Marsgate/goosebrain/renders/case/8_clear_side.png

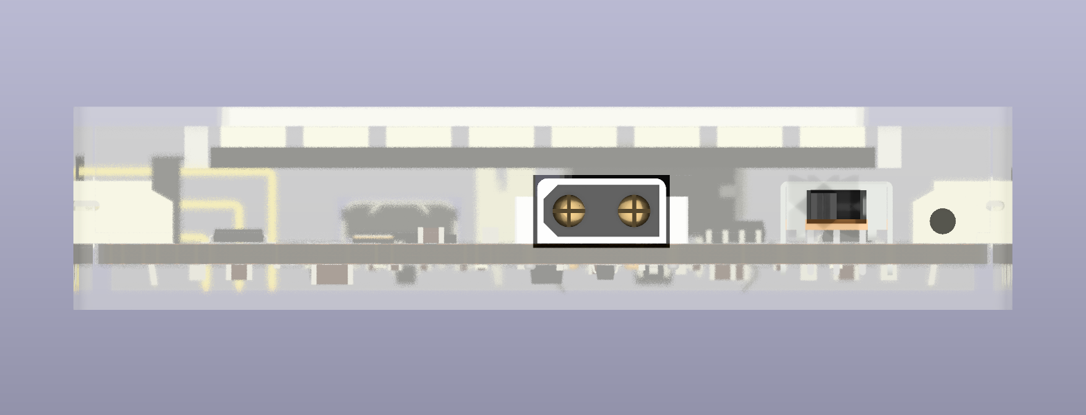
renders/case/8_clear_side.png
