Marsgate/goosebrain/renders/pack/compact_board.png

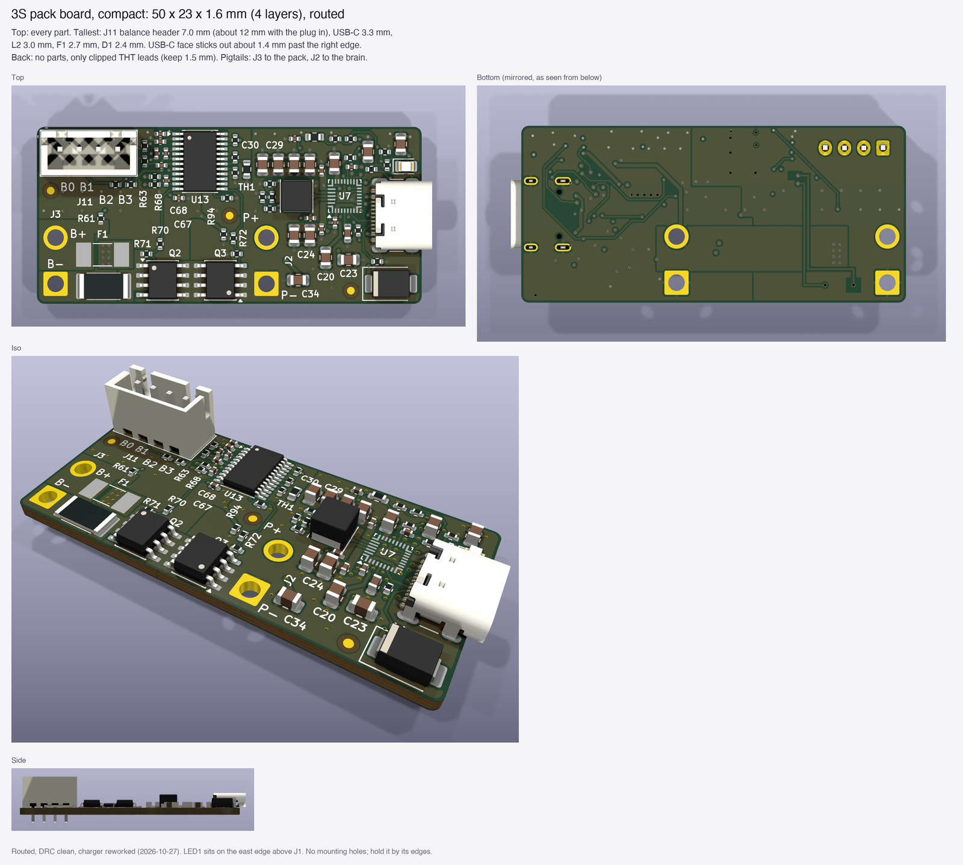
renders/pack/compact_board.png
