Marsgate/goosebrain/docs/ovonic-un38.3-request.md

Subject: UN38.3 test summary and SDS request: Ovonic 80C 11.1V 3S 450mAh XT30

Hello Ovonic team,

I'm designing a small robotics controller that ships with one of your packs installed in the equipment (UN3481), and I'd like to use the Ovonic 80C 11.1V 3S 450mAh LiPo with the XT30 plug:
https://www.ovonicshop.com/products/ovonic-80c-11-1v-3s-450mah-xt30-lipo-battery

Before I commit to it, could you send:

1. The UN38.3 test summary for this exact pack model (3S1P 450mAh 80C), as required for shipments since January 2020.
2. The full UN38.3 test report, if you can share it.
3. The current Safety Data Sheet (SDS/MSDS).
4. The cell model and cell manufacturer used in the pack, and the pack's watt-hour rating.
5. Whether the pack has IEC 62133 certification.

I'm planning an initial order of about [quantity] packs, with more to follow if the documents check out. If buying direct in volume needs a different contact, please point me to them.

Thank you,
[Your name]
[Company or project name]
[Email / phone]
