Marsgate/goosebrain/renders/board/1_top.png

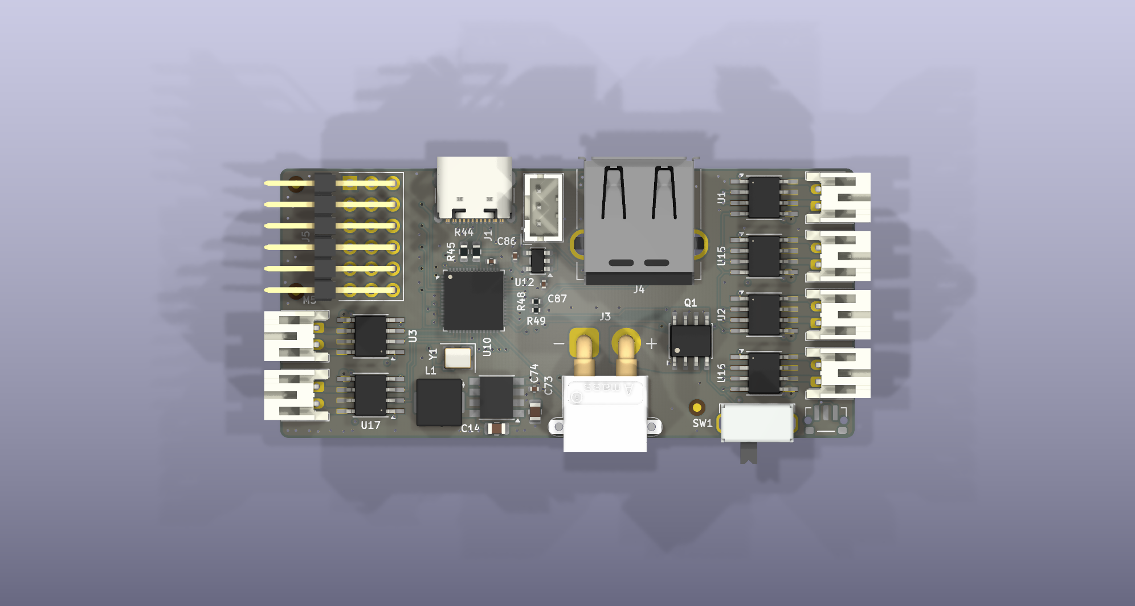
renders/board/1_top.png
