Marsgate/goosebrain/renders/board/2_bottom.png

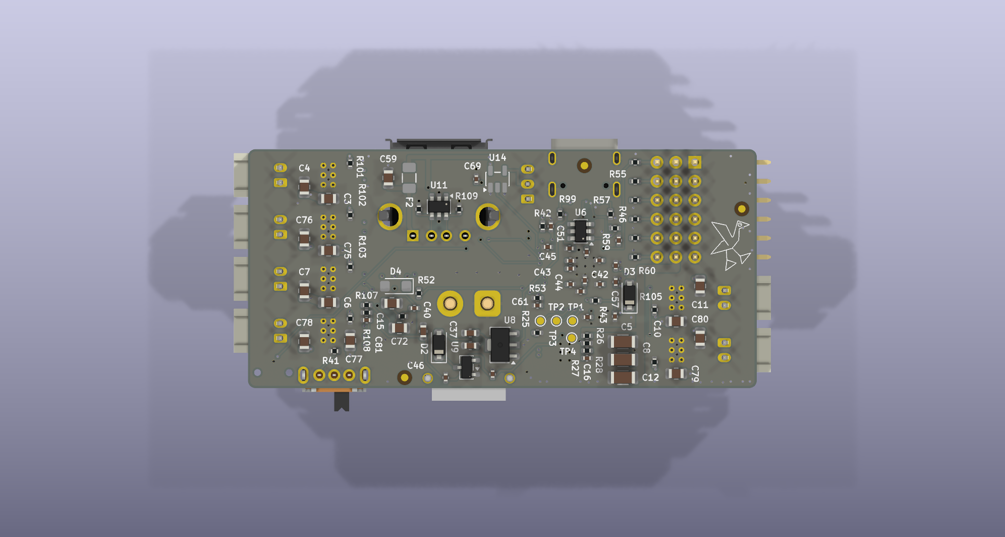
renders/board/2_bottom.png
