Marsgate/goosebrain/renders/board/3_iso_front.png

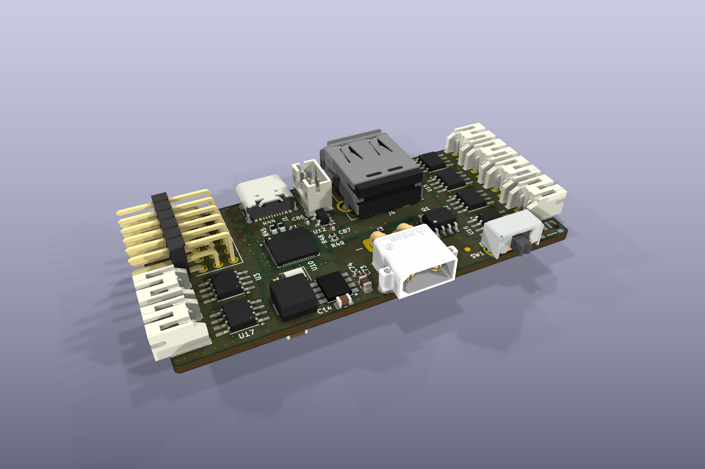
renders/board/3_iso_front.png
