Marsgate/goosebrain/renders/board/4_iso_back_edge.png

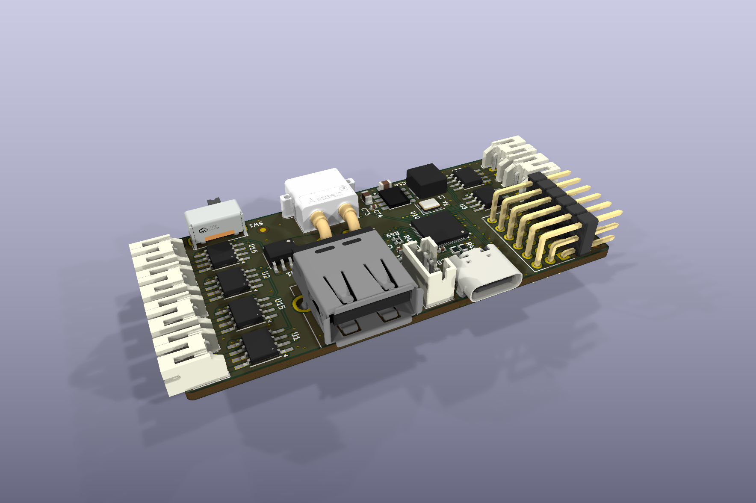
renders/board/4_iso_back_edge.png
