Marsgate/goosebrain/renders/board/5_iso_underside.png

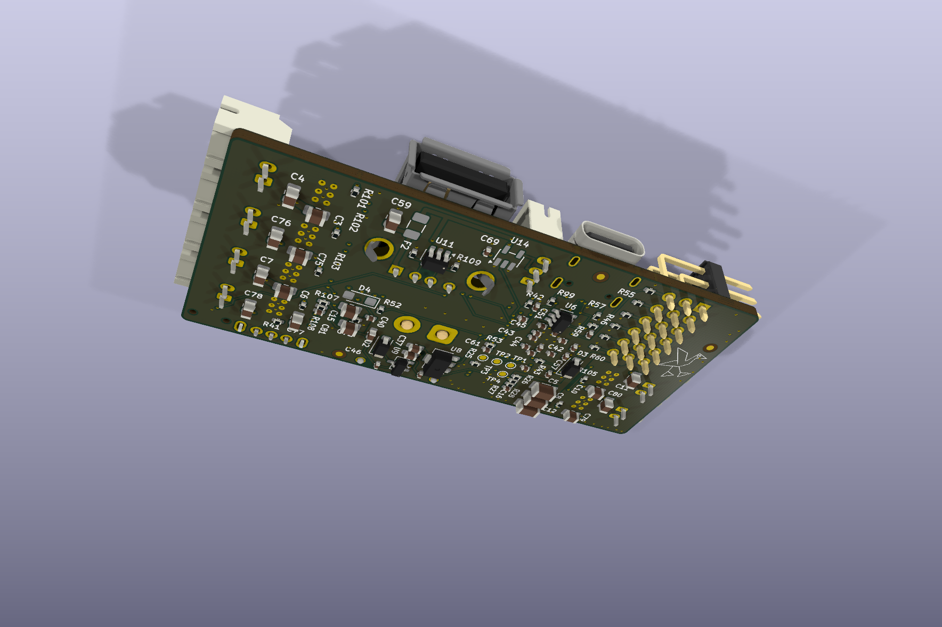
renders/board/5_iso_underside.png
