Marsgate/goosebrain/renders/case/1_on_robot.png

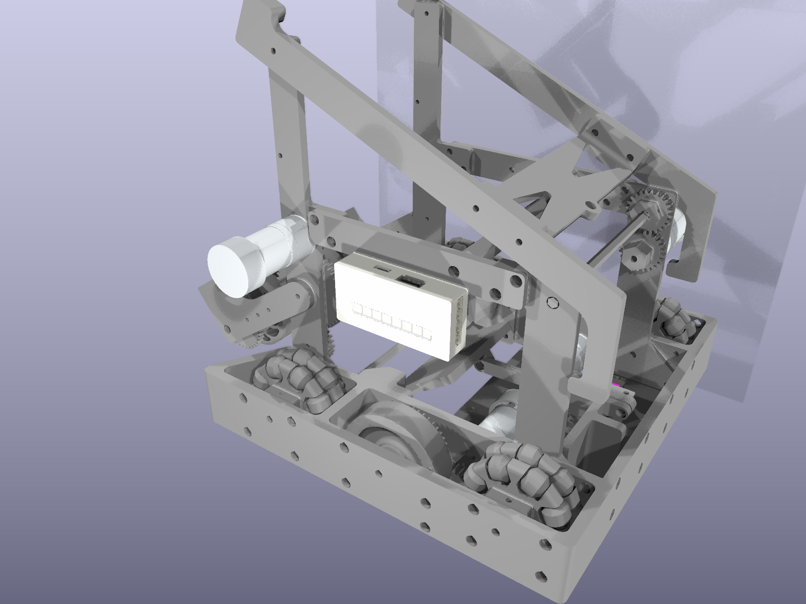
renders/case/1_on_robot.png
