Marsgate/goosebrain/renders/case/2_on_robot_closeup.png

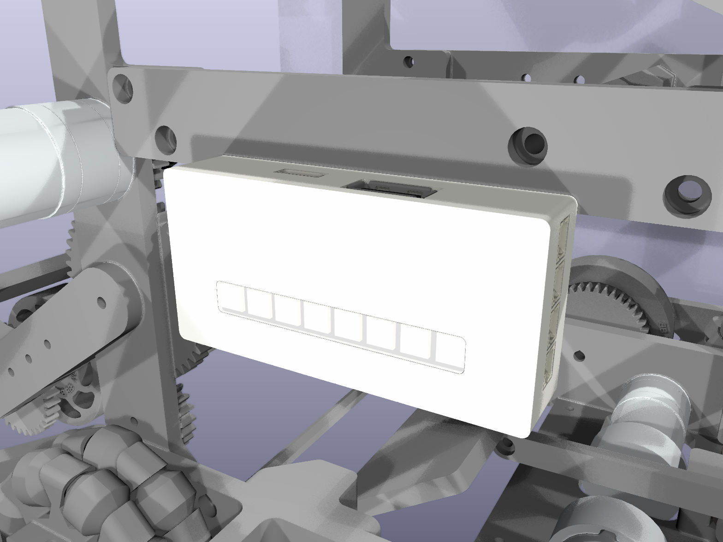
renders/case/2_on_robot_closeup.png
