Marsgate/goosebrain/renders/case/3_case_top_usb.png

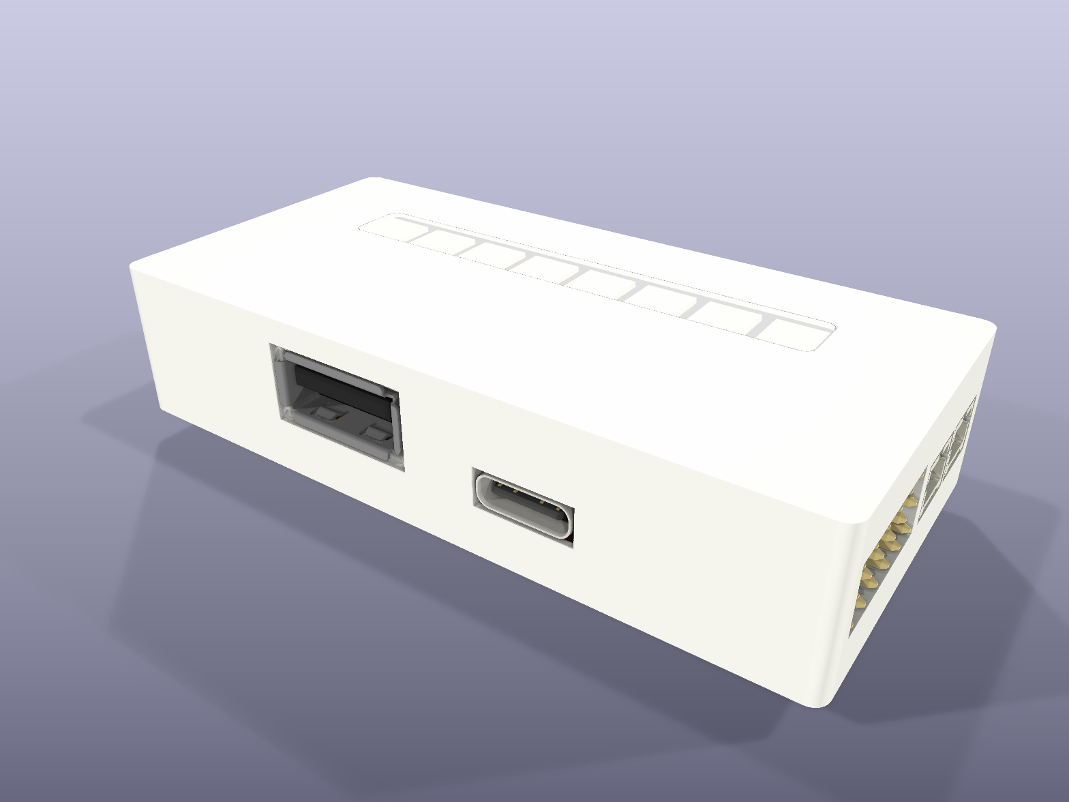
renders/case/3_case_top_usb.png
