Marsgate/goosebrain/renders/case/4_case_left_io.png

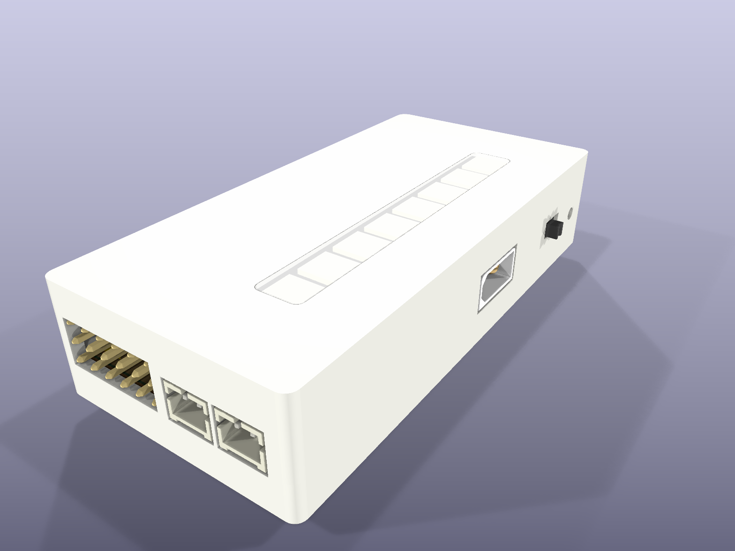
renders/case/4_case_left_io.png
