Marsgate/goosebrain/renders/case/6_case_bottom_power.png

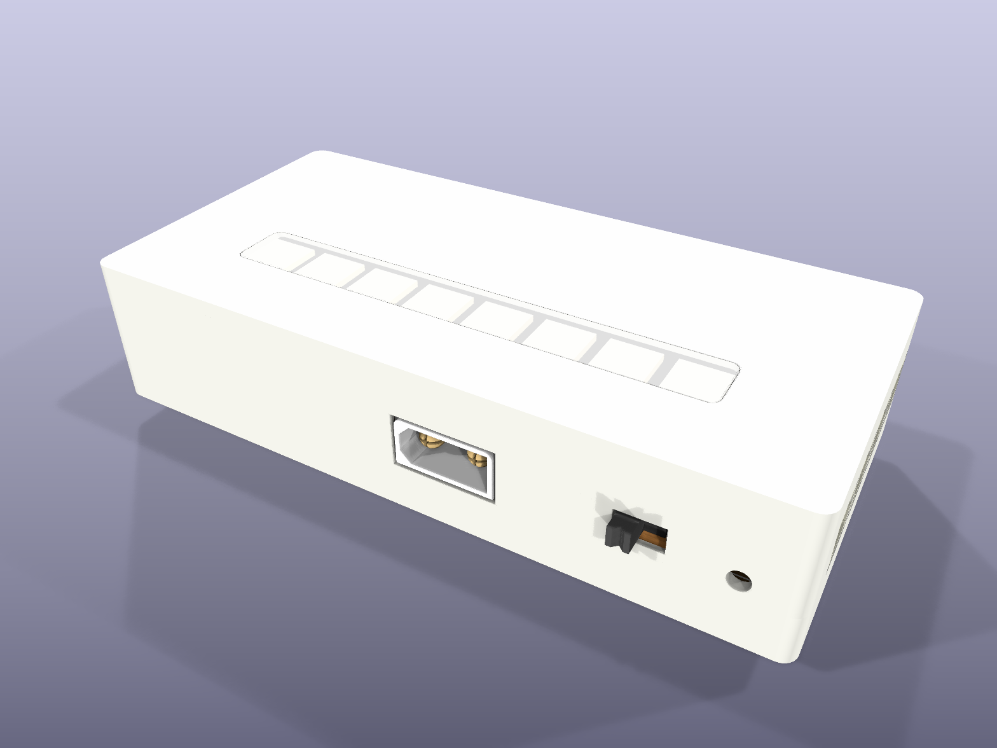
renders/case/6_case_bottom_power.png
