Marsgate/goosebrain/renders/case/7_clear_case.png

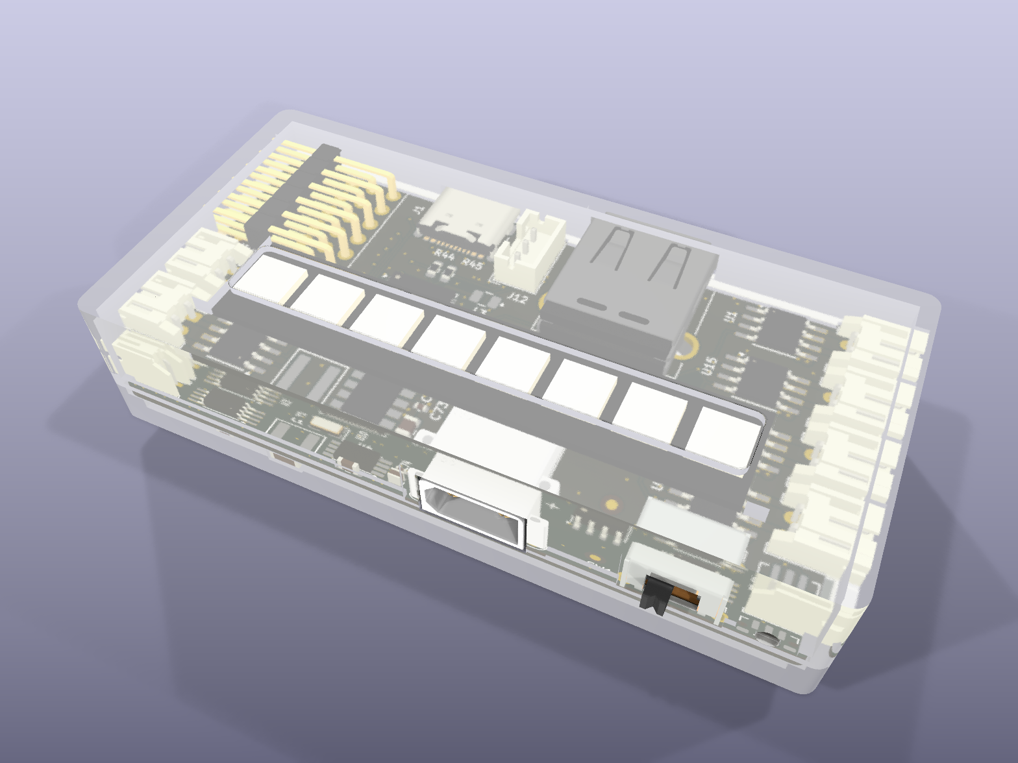
renders/case/7_clear_case.png
