Marsgate/goosebrain/renders/pack/layout_options.png

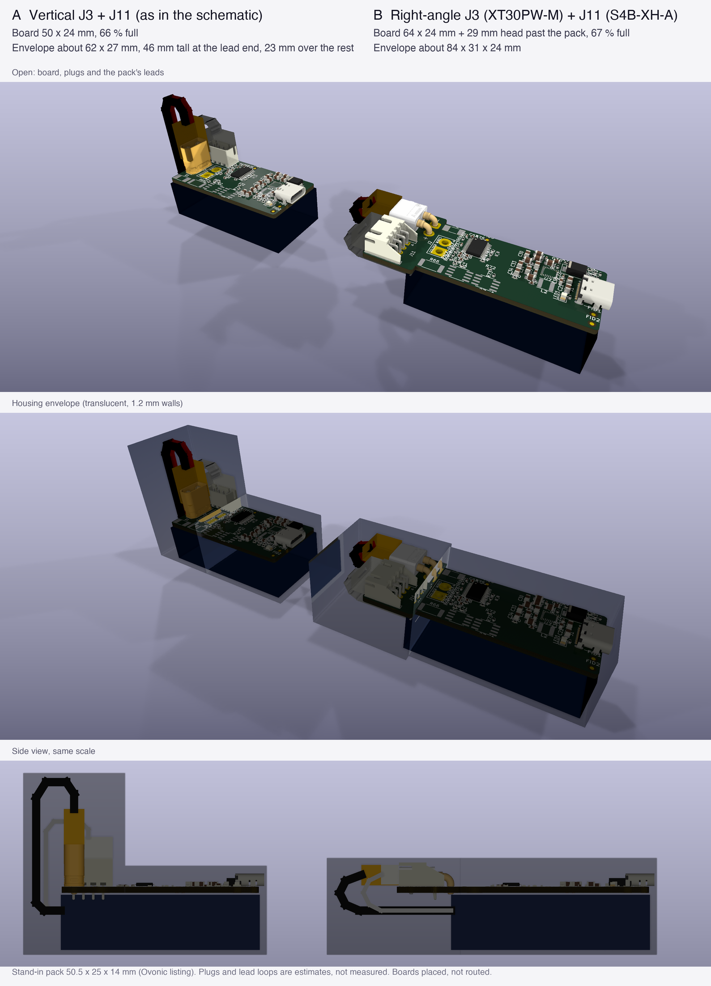
renders/pack/layout_options.png
