Marsgate/goosebrain/renders/pack/pack2s_bottom.png

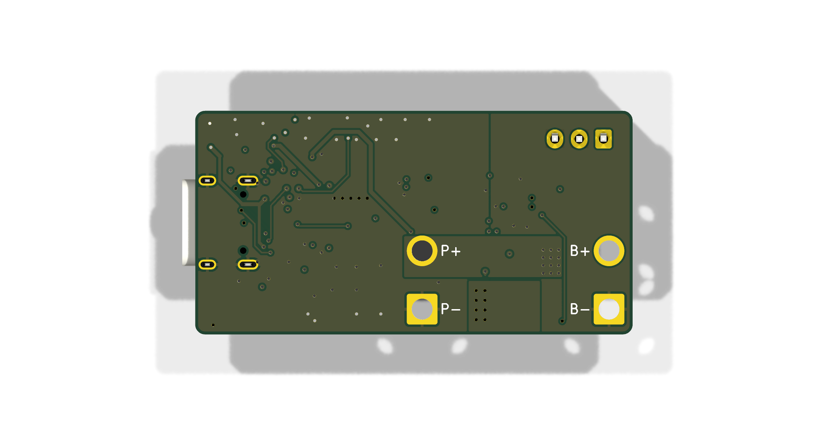
renders/pack/pack2s_bottom.png
