Marsgate/goosebrain/renders/pack/pack2s_iso.png

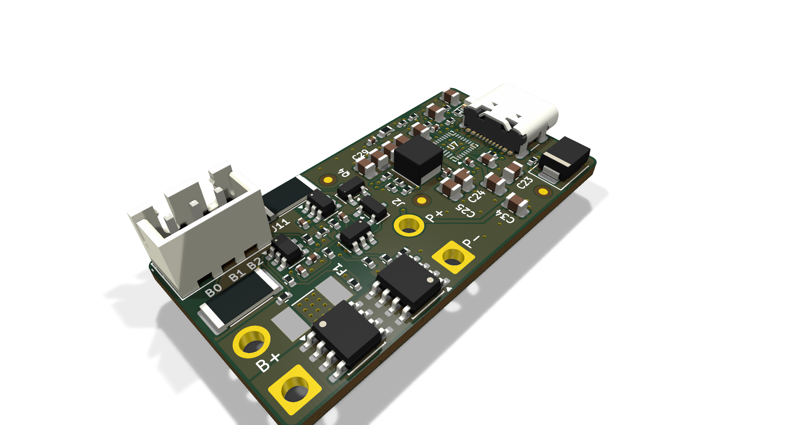
renders/pack/pack2s_iso.png
