Marsgate/goosebrain/renders/pack/pack2s_top.png

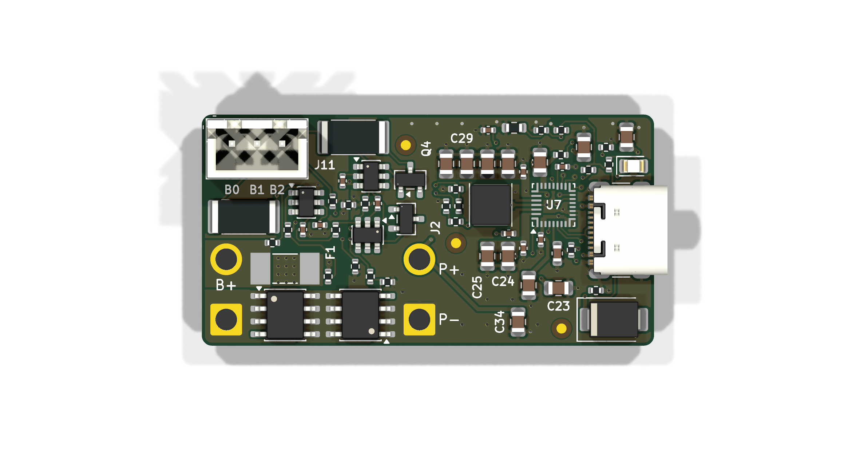
renders/pack/pack2s_top.png
