Marsgate/goosebrain/renders/pack/pack_on_top_vs_brain.png

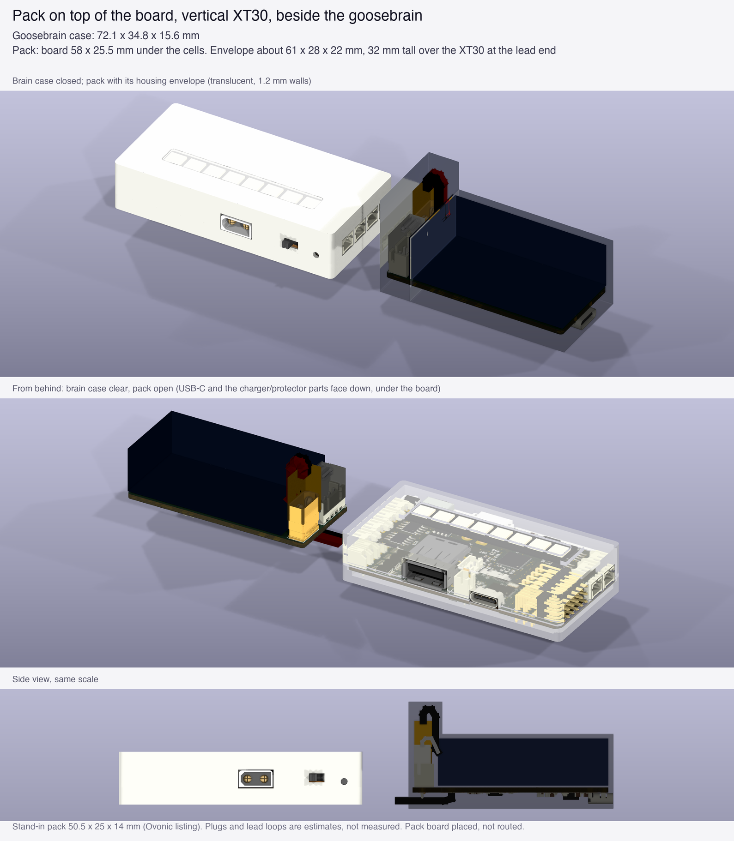
renders/pack/pack_on_top_vs_brain.png
