Marsgate/goosebrain/renders/pack/pack_vs_brain_boards.png

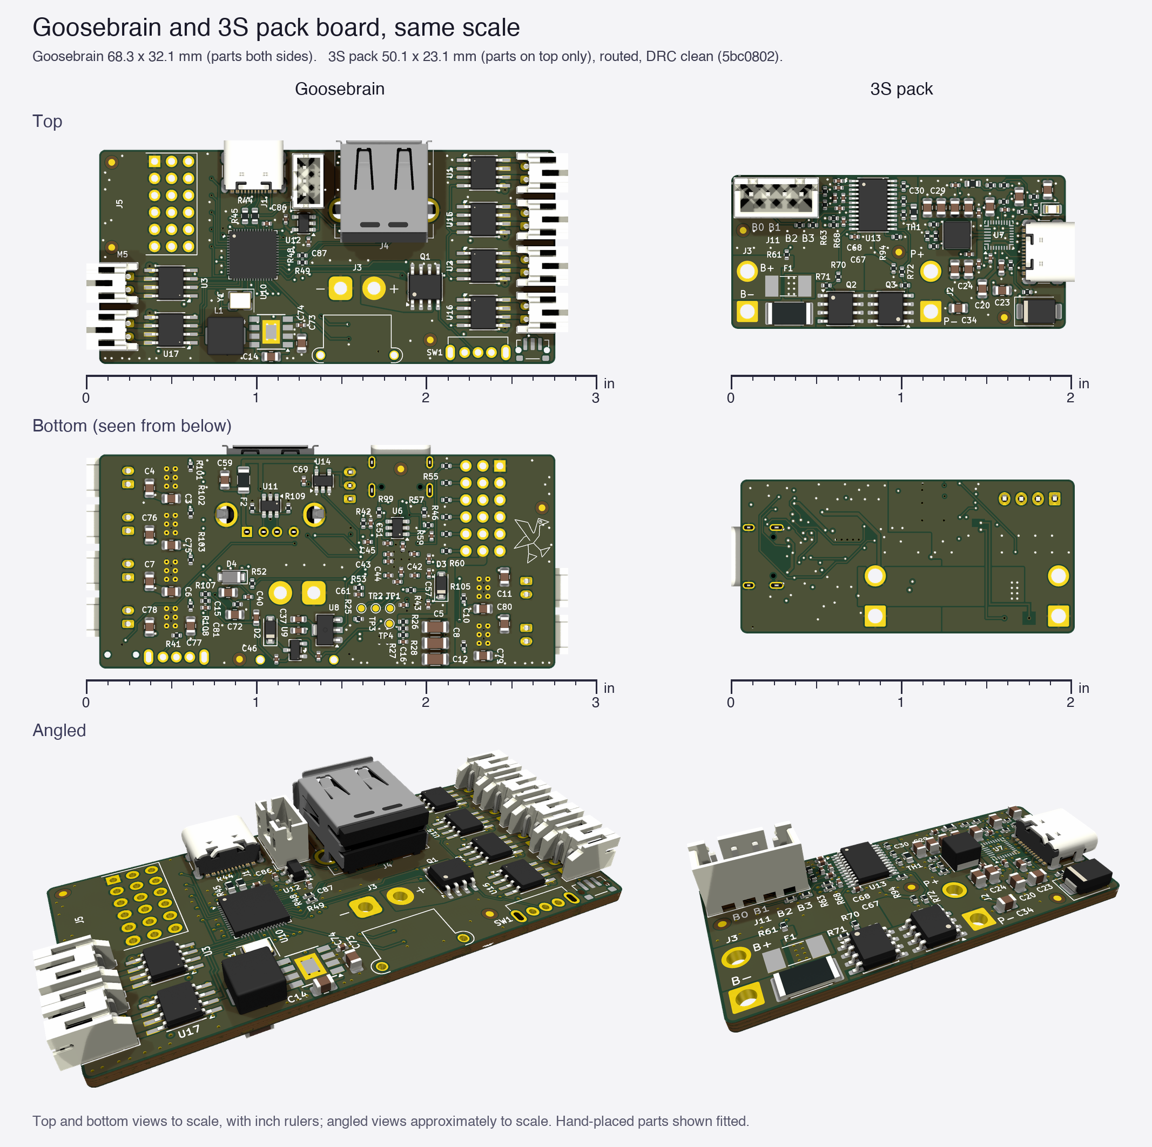
renders/pack/pack_vs_brain_boards.png
