Marsgate/goosebrain/renders/case/case_cover.step

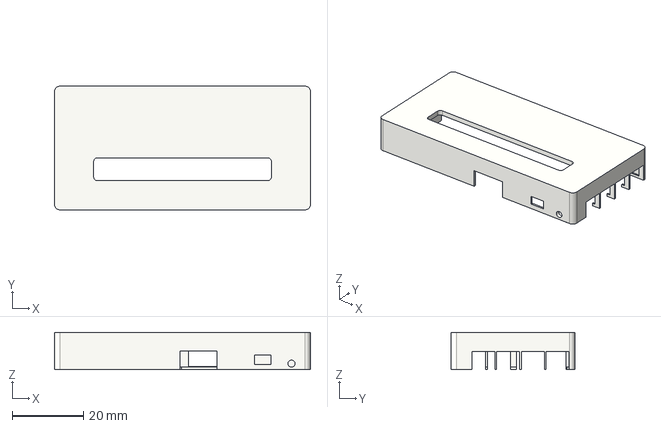
[picture p20: CAD file, 2026-10-20]
renders/case/case_cover.step
72.1 x 34.8 x 10.5 mm
