Marsgate/goosebrain/renders/case/case_diffuser.step

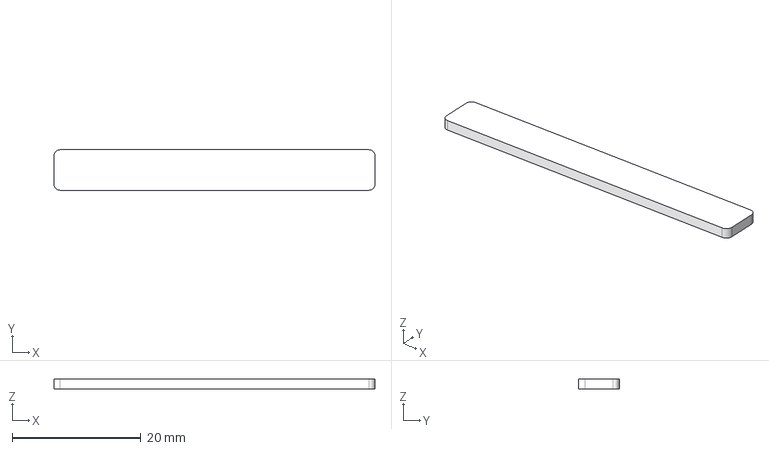
[picture p21: CAD file, 2026-10-20]
renders/case/case_diffuser.step
49.9 x 6.30 x 1.50 mm
