Marsgate/goosebrain/renders/case/led_stick.step

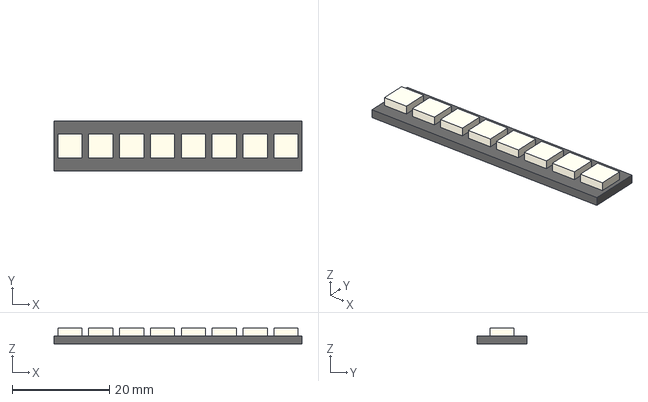
[picture p22: CAD file, 2026-10-20]
renders/case/led_stick.step
51.0 x 10.2 x 3.20 mm
