Marsgate/goosebrain/renders/case/case_tray.step

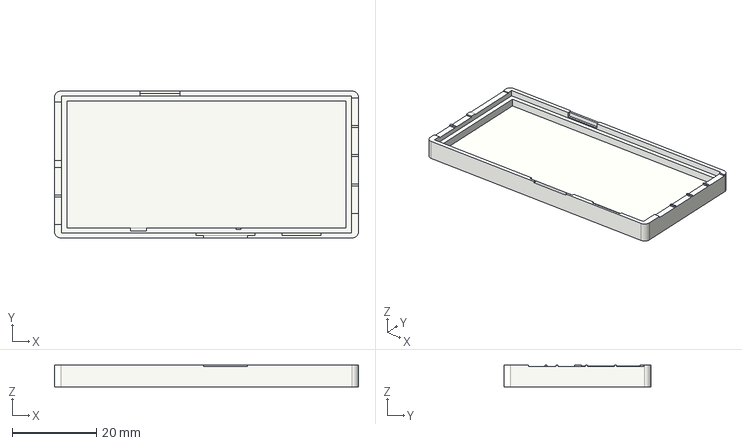
[picture p23: CAD file, 2026-10-20]
renders/case/case_tray.step
72.1 x 34.8 x 5.10 mm
