Marsgate/goosebrain/kicad-pack-2s/goosepack2s.kicad_pcb

## KiCad design kicad-pack-2s/goosepack2s.kicad_pcb (2026-10-29)

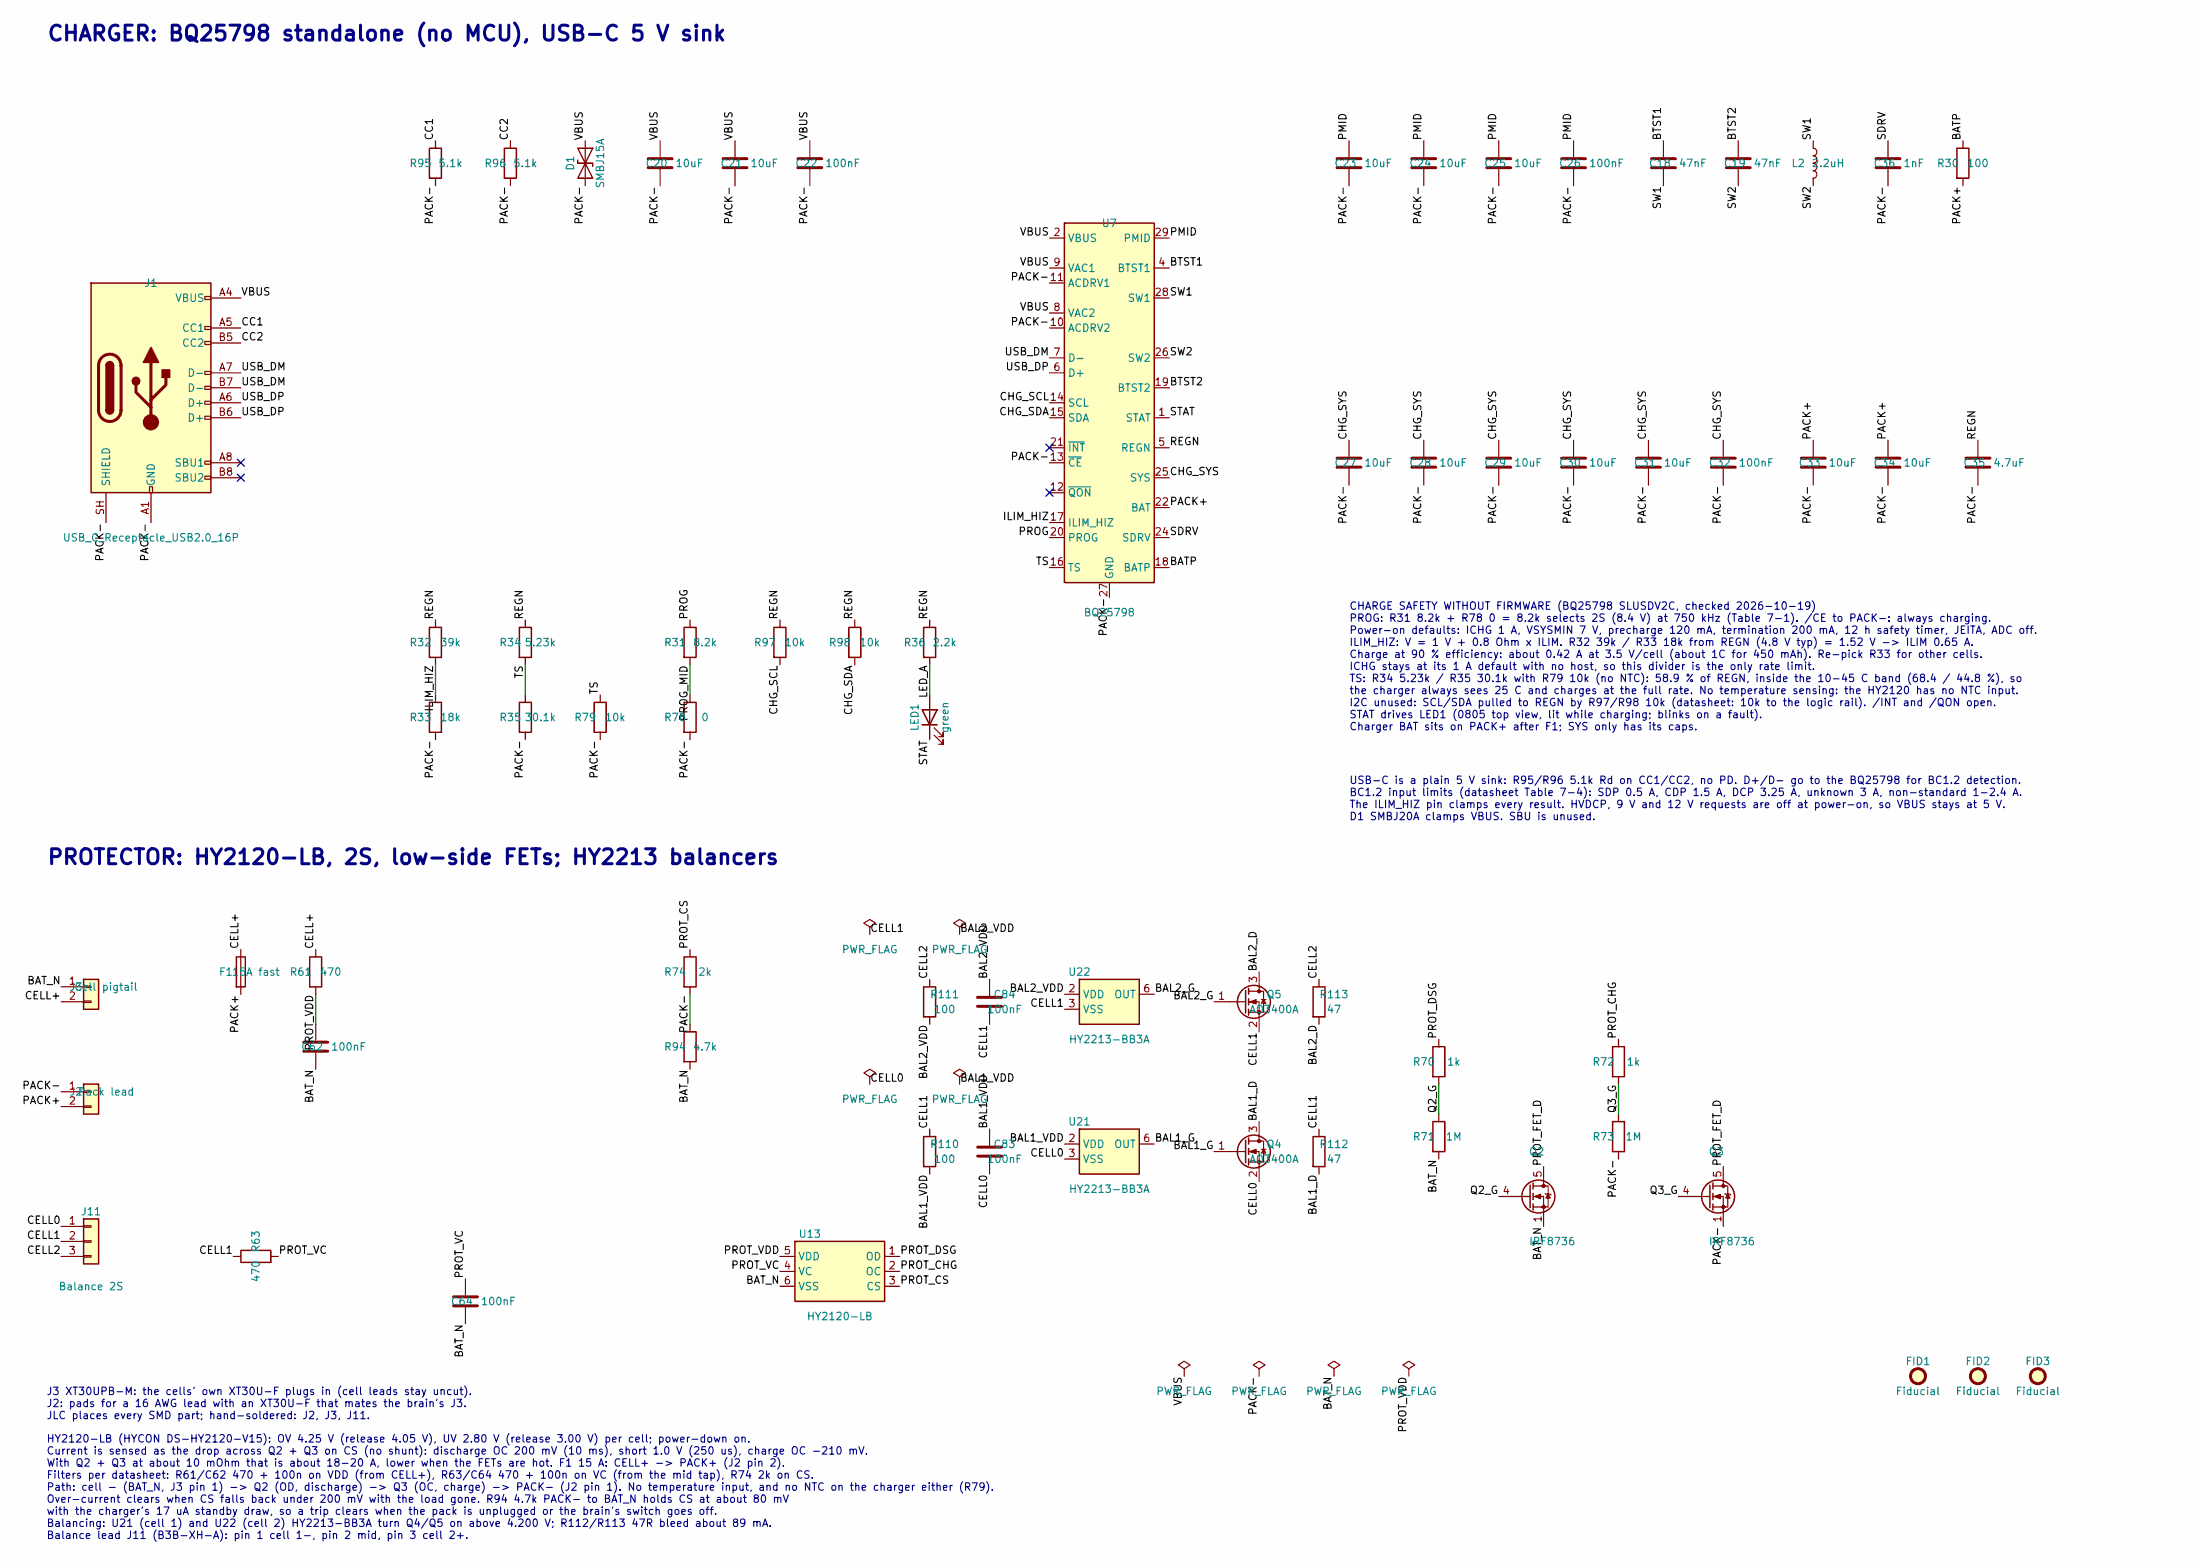
[picture p24: schematic goosepack2s.kicad_sch]

Parts:
C18, C19: 47nF; C_0402_1005Metric; MPN 0402B473K160NT; LCSC Part # C192385
C20, C21, C23, C24, C25, C27, C28, C29, C30, C31, C33, C34: 10uF; C_0805_2012Metric; MPN CL21A106KAYNNNE; LCSC Part # C15850
C22, C26, C32, C62, C64, C83, C84: 100nF; C_0402_1005Metric; MPN CL05B104KO5NNNC; LCSC Part # C1525
C35: 4.7uF; C_0603_1608Metric; MPN CL10A475KO8NNNC; LCSC Part # C19666
C36: 1nF; C_0402_1005Metric; MPN 0402B102K500NT; LCSC Part # C1523
D1: SMBJ15A; D_SMB; MPN SMBJ15A; LCSC Part # C19077569
F1: 15A fast; Fuse_Littelfuse-NANO2-451_453; MPN 0453015.MR; LCSC Part # C178997
FID1, FID2, FID3: Fiducial; Fiducial_1mm_Mask2mm
J1: USB_C_Receptacle_USB2.0_16P; USB_C_Receptacle_ShouHan_TYPE-C16PIN; MPN TYPE-C16PIN; LCSC Part # C393939
J2: Pack lead; SolderWire-1.5sqmm_1x02_P6mm_D1.7mm_OD3mm; MPN XT30U-F; LCSC Part # C99102
J3: Cell pigtail; SolderWire-1.5sqmm_1x02_P6mm_D1.7mm_OD3mm; MPN XT30U-M; LCSC Part # C99101
J11: Balance 2S; JST_XH_B3B-XH-A_1x03_P2.50mm_Vertical; MPN B3B-XH-A(LF)(SN); LCSC Part # C144394
L2: 2.2uH; L_Changjiang_FNR4030S; MPN FNR4030S2R2MT; LCSC Part # C167869
LED1: green; LED_0805_2012Metric; MPN KT-0805G; LCSC Part # C2297
Q2, Q3: IRF8736; SOIC-8_3.9x4.9mm_P1.27mm; MPN IRF8736TRPBF; LCSC Part # C51630
Q4, Q5: AO3400A; SOT-23-3; MPN AO3400A; LCSC Part # C20917
R30, R110, R111: 100; R_0402_1005Metric; MPN 0402WGF1000TCE; LCSC Part # C25076
R31: 8.2k; R_0402_1005Metric; MPN 0402WGF8201TCE; LCSC Part # C25924
R32: 39k; R_0402_1005Metric; MPN 0402WGF3902TCE; LCSC Part # C25783
R33: 18k; R_0402_1005Metric; MPN 0402WGF1802TCE; LCSC Part # C25762
R34: 5.23k; R_0402_1005Metric; MPN RTT025231FTH; LCSC Part # C11631
R35: 30.1k; R_0402_1005Metric; MPN 0402WGF3012TCE; LCSC Part # C29402
R36: 2.2k; R_0402_1005Metric; MPN 0402WGF2201TCE; LCSC Part # C25879
R61, R63: 470; R_0402_1005Metric; MPN 0402WGF4700TCE; LCSC Part # C25117
R70, R72: 1k; R_0402_1005Metric; MPN 0402WGF1001TCE; LCSC Part # C11702
R71, R73: 1M; R_0402_1005Metric; MPN 0402WGF1004TCE; LCSC Part # C26083
R74: 2k; R_0402_1005Metric; MPN 0402WGF2001TCE; LCSC Part # C4109
R78: 0; R_0402_1005Metric; MPN 0402WGF0000TCE; LCSC Part # C17168
R79: 10k; R_0603_1608Metric; MPN 0603WAF1002T5E; LCSC Part # C25804
R94: 4.7k; R_0402_1005Metric; MPN 0402WGF4701TCE; LCSC Part # C25900
R95, R96: 5.1k; R_0402_1005Metric; MPN 0402WGF5101TCE; LCSC Part # C25905
R97, R98: 10k; R_0402_1005Metric; MPN 0402WGF1002TCE; LCSC Part # C25744
R112, R113: 47; R_2512_6332Metric; MPN 25121WJ0470T4E; LCSC Part # C15261
U7: BQ25798; Texas_RQM0029A_VQFN-29_4x4mm_P0.4mm; MPN BQ25798RQMR; LCSC Part # C2876593
U13: HY2120-LB; SOT-23-6; MPN HY2120-LB; LCSC Part # C168778
U21, U22: HY2213-BB3A; SOT-23-6; MPN HY2213-BB3A; LCSC Part # C113632

Connections:
/BAL1_D: Q4.3 (D), R112.2
/BAL1_G: Q4.1 (G), U21.6 (OUT)
/BAL1_VDD: C83.1, R110.2, U21.2 (VDD)
/BAL2_D: Q5.3 (D), R113.2
/BAL2_G: Q5.1 (G), U22.6 (OUT)
/BAL2_VDD: C84.1, R111.2, U22.2 (VDD)
/BATP: R30.1, U7.18 (BATP)
/BAT_N: C62.2, C64.2, J3.1, Q2.1 (S), Q2.2 (S), Q2.3 (S), R71.2, R94.2, U13.6 (VSS)
/BTST1: C18.1, U7.4 (BTST1)
/BTST2: C19.1, U7.19 (BTST2)
/CC1: J1.A5 (CC1), R95.1
/CC2: J1.B5 (CC2), R96.1
/CELL0: C83.2, J11.1, Q4.2 (S), U21.3 (VSS)
/CELL1: C84.2, J11.2, Q5.2 (S), R63.1, R110.1, R112.1, U22.3 (VSS)
/CELL2: J11.3, R111.1, R113.1
/CELL+: F1.1, J3.2, R61.1
/CHG_SCL: R97.2, U7.14 (SCL)
/CHG_SDA: R98.2, U7.15 (SDA)
/CHG_SYS: C27.1, C28.1, C29.1, C30.1, C31.1, C32.1, U7.25 (SYS)
/ILIM_HIZ: R32.2, R33.1, U7.17 (ILIM_HIZ)
/LED_A: LED1.2 (A), R36.2
/PACK+: C33.1, C34.1, F1.2, J2.2, R30.2, U7.22 (BAT), U7.23 (BAT)
/PACK-: C20.2, C21.2, C22.2, C23.2, C24.2, C25.2, C26.2, C27.2, C28.2, C29.2, C30.2, C31.2, C32.2, C33.2, C34.2, C35.2, C36.2, D1.2 (A2), J1.A1 (GND), J1.A12 (GND), J1.B1 (GND), J1.B12 (GND), J1.SH (SHIELD), J2.1, Q3.1 (S), Q3.2 (S), Q3.3 (S), R33.2, R35.2, R73.2, R74.2, R78.2, R79.2, R94.1, R95.2, R96.2, U7.10 (ACDRV2), U7.11 (ACDRV1), U7.13 (~CE), U7.27 (GND)
/PMID: C23.1, C24.1, C25.1, C26.1, U7.29 (PMID)
/PROG: R31.1, U7.20 (PROG)
/PROG_MID: R31.2, R78.1
/PROT_CHG: R72.1, U13.2 (OC)
/PROT_CS: R74.1, U13.3 (CS)
/PROT_DSG: R70.1, U13.1 (OD)
/PROT_FET_D: Q2.5 (D), Q2.6 (D), Q2.7 (D), Q2.8 (D), Q3.5 (D), Q3.6 (D), Q3.7 (D), Q3.8 (D)
/PROT_VC: C64.1, R63.2, U13.4 (VC)
/PROT_VDD: C62.1, R61.2, U13.5 (VDD)
/Q2_G: Q2.4 (G), R70.2, R71.1
/Q3_G: Q3.4 (G), R72.2, R73.1
/REGN: C35.1, R32.1, R34.1, R36.1, R97.1, R98.1, U7.5 (REGN)
/SDRV: C36.1, U7.24 (SDRV)
/STAT: LED1.1 (K), U7.1 (STAT)
/SW1: C18.2, L2.1, U7.28 (SW1)
/SW2: C19.2, L2.2, U7.26 (SW2)
/TS: R34.2, R35.1, R79.1, U7.16 (TS)
/USB_DM: J1.A7 (D-), J1.B7 (D-), U7.7 (D-)
/USB_DP: J1.A6 (D+), J1.B6 (D+), U7.6 (D+)
/VBUS: C20.1, C21.1, C22.1, D1.1 (A1), J1.A4 (VBUS), J1.A9 (VBUS), J1.B4 (VBUS), J1.B9 (VBUS), U7.2 (VBUS), U7.3 (VBUS), U7.8 (VAC2), U7.9 (VAC1)

Notes on the sheet:
CHARGER: BQ25798 standalone (no MCU), USB-C 5 V sink
PROTECTOR: HY2120-LB, 2S, low-side FETs; HY2213 balancers
USB-C is a plain 5 V sink: R95/R96 5.1k Rd on CC1/CC2, no PD. D+/D- go to the BQ25798 for BC1.2 detection. BC1.2 input limits (datasheet Table 7-4): SDP 0.5 A, CDP 1.5 A, DCP 3.25 A, unknown 3 A, non-standard 1-2.4 A. The ILIM_HIZ pin clamps every result. HVDCP, 9 V and 12 V requests are off at pow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
CHARGE SAFETY WITHOUT FIRMWARE (BQ25798 SLUSDV2C, checked 2026-10-19) PROG: R31 8.2k + R78 0 = 8.2k selects 2S (8.4 V) at 750 kHz (Table 7-1). /CE to PACK-: always charging. Power-on defaults: ICHG 1 A, VSYSMIN 7 V, precharge 120 mA, termination 200 mA, 12 h safety timer, JEITA, ADC off. ILIM_HIZ: 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
HY2120-LB (HYCON DS-HY2120-V15): OV 4.25 V (release 4.05 V), UV 2.80 V (release 3.00 V) per cell; power-down on. Current is sensed as the drop across Q2 + Q3 on CS (no shunt): discharge OC 200 mV (10 ms), short 1.0 V (250 us), charge OC -210 mV. With Q2 + Q3 at about 10 mOhm that is about 18-20 A, 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
J3 XT30UPB-M: the cells' own XT30U-F plugs in (cell leads stay uncut). J2: pads for a 16 AWG lead with an XT30U-F that mates the brain's J3. JLC places every SMD part; hand-soldered: J2, J3, J11.

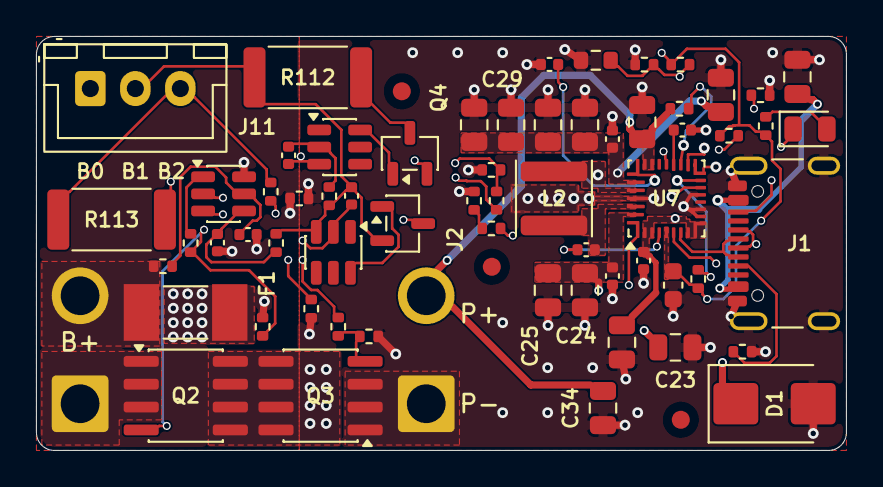
[picture p25: board goosepack2s.kicad_pcb from above]

Board: 4 copper layers, 45.0 x 23.0 mm, 67 parts (0 on the bottom side), 43 nets.
