Marsgate/goosebrain/kicad/thegoose.kicad_pcb

## KiCad design kicad/thegoose.kicad_pcb (2026-10-20)

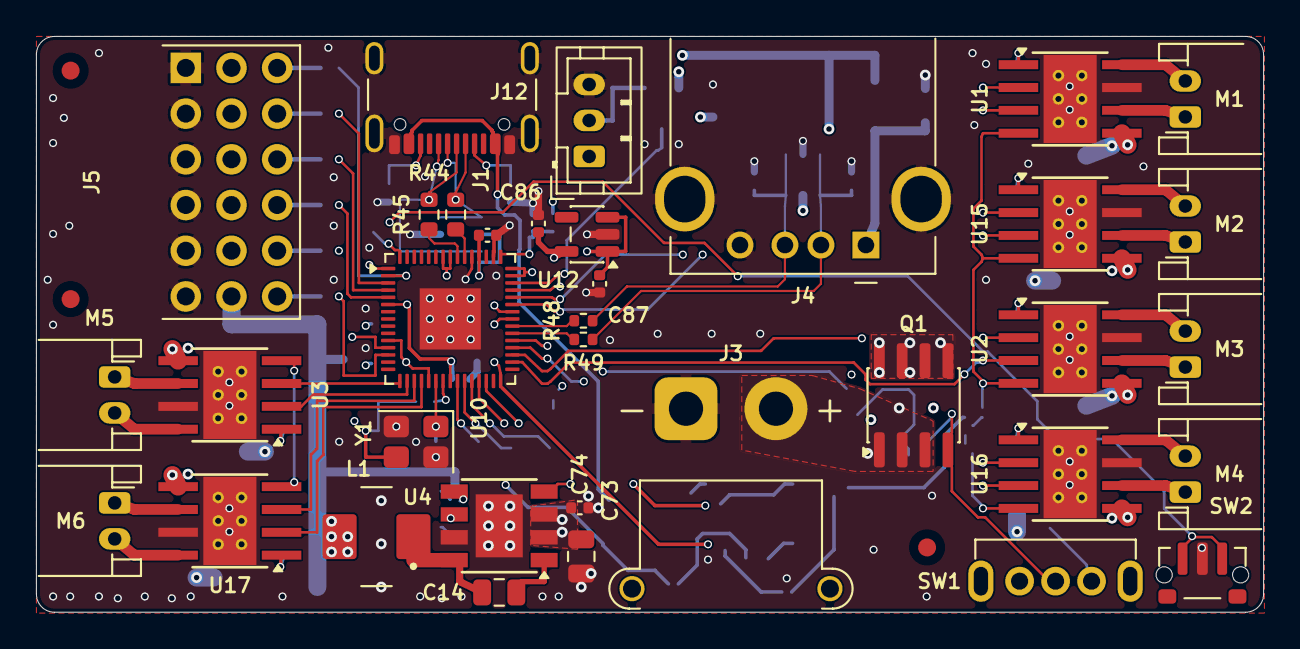
[picture p26: board kicad/thegoose.kicad_pcb from above]

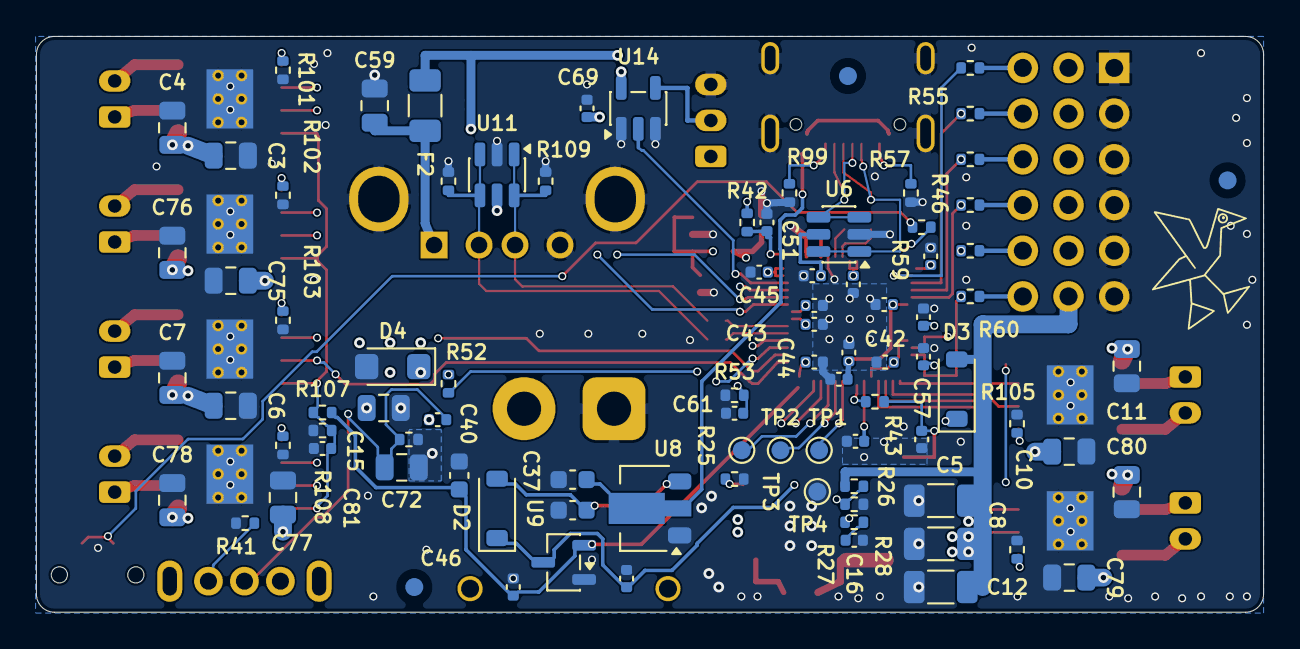
[picture p27: board kicad/thegoose.kicad_pcb from below]

Board: 6 copper layers, 68.2 x 32.0 mm, 127 parts (89 on the bottom side), 83 nets.

Parts:
C3, C6, C10, C15, C59, C73, C75, C77, C79: 10uF; C_0805_2012Metric
C4, C7, C11, C14, C72, C76, C78, C80: 100nF; C_0805_2012Metric
C5, C8, C12: 22uF; C_1206_3216Metric
C16: 4.7nF; C_0402_1005Metric
C37: 1uF; C_0603_1608Metric
C38, C40: 10uF; C_0603_1608Metric
C39: 1uF; C_0402_1005Metric
C41, C42, C43, C44, C45, C46, C47, C48, C49, C53, C54, C55, C61, C69, C74, C81: 100nF; C_0402_1005Metric
C50, C51, C52, C85, C86, C87: 4.7uF; C_0402_1005Metric
C56, C57: 15pF; C_0402_1005Metric
C71: 10nF; C_0402_1005Metric
D2, D3: B5819W; D_SOD-123
D4: SMF14A; D_SMF
F2: 0.5A hold; Fuse_1206_3216Metric
FID1, FID2, FID3, FID4, FID5, FID6: Fiducial; Fiducial_1mm_Mask2mm
J1: USB_C_Receptacle_USB2.0_16P; USB_C_Receptacle_ShouHan_TYPE-C16PIN
J3: XT30PW-M; AMASS_XT30PW-M_1x02_P2.50mm_Horizontal
J4: USB-A host; USB_A_ShouHan_AF90_WJDG
J5: IO 3x6 RA; PinHeader_3x06_P2.54mm_Horizontal_WingTAT
J12: LED stick; JST_PH_B3B-PH-K_1x03_P2.00mm_Vertical
L1: 2.2uH; L_ZengYi_HMS0530
M1, M2, M3, M4, M5, M6: JST_PH_S2B-PH-K_1x02_P2.00mm_Horizontal
Q1: AO4407A; SOIC-8_3.9x4.9mm_P1.27mm
R25: 200k; R_0402_1005Metric
R26: 39k; R_0402_1005Metric
R27: 7.5k; R_0402_1005Metric
R28, R109, R114: 15k; R_0402_1005Metric
R40: 47k; R_0402_1005Metric
R41: 4.7k; R_0402_1005Metric
R42: 33; R_0402_1005Metric
R43, R46: 1k; R_0402_1005Metric
R44, R45: 27; R_0603_1608Metric
R48, R49: 22; R_0402_1005Metric
R52: 100k; R_0402_1005Metric
R53: 27k; R_0402_1005Metric
R55, R56, R57, R58, R59, R60: 330; R_0402_1005Metric
R99, R100: 5.1k; R_0402_1005Metric
R101, R102, R103, R104, R105, R106: 1.2k; R_0402_1005Metric
R107: 10k; R_0402_1005Metric
R108: 33k; R_0402_1005Metric
SW1: Power; SW_SPDT_ShouHan_SK12D07VG4
SW2: BOOT; SW_Push_1P1T-MP_NO_Horizontal_Alps_SKRTLAE010_JLC
TP1: SWCLK; TestPoint_Pad_D1.0mm
TP2: SWDIO; TestPoint_Pad_D1.0mm
TP3: RUN; TestPoint_Pad_D1.0mm
TP4: GND; TestPoint_Pad_D1.0mm
U1, U2, U3, U15, U16, U17: DRV8251A; Texas_HTSOP-8-1EP_3.9x4.9mm_P1.27mm_EP2.95x4.9mm_Mask2.4x3.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
U4: AP64500SP-13; Diodes_SO-8EP
U6, U11: SRV05-4; SOT-23-6
U8: HT7550-1; SOT-89-3
U9: XC6206P332MR; SOT-23-3
U10: RP2354A; QFN-60-1EP_7x7mm_P0.4mm_EP3.4x3.4mm
U12: TLV74311PDBV; SOT-23-5
U14: 74AHCT1G125; SOT-23-5
Y1: 12MHz; Crystal_SMD_3225-4Pin_3.2x2.5mm

Connections:
+1V1: C52.1, C53.1, C54.1, C55.1, C86.1, U10.6 (DVDD), U10.23 (DVDD), U10.39 (DVDD), U12.5
+3V3: C40.1, C41.1, C42.1, C43.1, C44.1, C45.1, C46.1, C47.1, C48.1, C49.1, C50.1, C85.1, C87.1, R42.1, R107.1, U6.5 (VP), U9.2 (VOUT), U10.1 (IOVDD), U10.11 (IOVDD), U10.20 (IOVDD), U10.30 (IOVDD), U10.38 (IOVDD), U10.44 (ADC_AVDD), U10.45 (IOVDD), U10.49 (VREG_VIN), U10.53 (USB_OTP_VDD), U10.54 (QSPI_IOVDD), U12.1, U12.3
/MCU & USB/BAT_SENSE: C61.1, R52.2, R53.1, U10.42 (GPIO28/ADC2)
/MCU & USB/RUN: TP3.1 (1_1), U10.26 (RUN)
/MCU & USB/USBA_GPIO_N: R49.1, U10.36 (GPIO24)
/MCU & USB/USBA_GPIO_P: R48.1, U10.37 (GPIO25)
/MCU & USB/USBA_N: J4.2 (D-), R49.2, R114.1, U11.3 (IO2), U11.4 (IO3)
/MCU & USB/USBA_P: J4.3 (D+), R48.2, R109.1, U11.1 (IO1), U11.6 (IO4)
/MCU & USB/USB_MCU_N: R45.1, U10.51 (USB_DM)
/MCU & USB/USB_MCU_P: R44.1, U10.52 (USB_DP)
/Motor drivers/MOT_VREF: C81.1, R107.2, R108.1, U1.4 (VREF), U2.4 (VREF), U3.4 (VREF), U15.4 (VREF), U16.4 (VREF), U17.4 (VREF)
/Motor drivers/U1_IPROPI: R101.1, U1.1 (IPROPI)
/Motor drivers/U1_OUT1: M1.1, U1.6 (OUT1)
/Motor drivers/U1_OUT2: M1.2, U1.8 (OUT2)
/Motor drivers/U2_IPROPI: R103.1, U2.1 (IPROPI)
/Motor drivers/U2_OUT1: M3.1, U2.6 (OUT1)
/Motor drivers/U2_OUT2: M3.2, U2.8 (OUT2)
/Motor drivers/U3_IPROPI: R105.1, U3.1 (IPROPI)
/Motor drivers/U3_OUT1: M5.1, U3.6 (OUT1)
/Motor drivers/U3_OUT2: M5.2, U3.8 (OUT2)
/Motor drivers/U15_IPROPI: R102.1, U15.1 (IPROPI)
/Motor drivers/U15_OUT1: M2.2, U15.8 (OUT2)
/Motor drivers/U15_OUT2: M2.1, U15.6 (OUT1)
/Motor drivers/U16_IPROPI: R104.1, U16.1 (IPROPI)
/Motor drivers/U16_OUT1: M4.2, U16.8 (OUT2)
/Motor drivers/U16_OUT2: M4.1, U16.6 (OUT1)
/Motor drivers/U17_IPROPI: R106.1, U17.1 (IPROPI)
/Motor drivers/U17_OUT1: M6.2, U17.8 (OUT2)
/Motor drivers/U17_OUT2: M6.1, U17.6 (OUT1)
/Power/CC1: J1.A5 (CC1), R99.1
/Power/CC2: J1.B5 (CC2), R100.1
GND: C3.1, C4.2, C5.2, C6.1, C7.2, C8.2, C10.1, C11.2, C12.2, C15.1, C16.1, C37.2, C38.2, C39.2, C40.2, C41.2, C42.2, C43.2, C44.2, C45.2, C46.2, C47.2, C48.2, C49.2, C50.2, C51.2, C52.2, C53.2, C54.2, C55.2, C56.2, C57.2, C59.2, C61.2, C69.2, C73.1, C74.1, C75.2, C76.2, C77.2, C78.2, C79.2, C80.2, C81.2, C85.2, C86.2, C87.2, D4.2 (A2), J1.A1 (GND), J1.A12 (GND), J1.B1 (GND), J1.B12 (GND), J1.SH (SHIELD), J3.1, J4.4 (GND), J4.SH (Shield), J5.1 (GND), J5.4 (GND), J5.7 (GND), J5.10 (GND), J5.13 (GND), J5.16 (GND), J12.3, R25.1, R27.1, R41.2, R53.2, R99.2, R100.2, R101.2, R102.2, R103.2, R104.2, R105.2, R106.2, R108.2, R109.2, R114.2, SW2.2, TP4.1 (1_1), U1.7 (GND), U1.9 (GND), U2.7 (GND), U2.9 (GND), U3.7 (GND), U3.9 (GND), U4.7 (GND), U4.9 (EP), U6.2 (VN), U8.1 (GND), U9.1 (GND), U10.47 (VREG_PGND), U10.50 (VREG_FB), U10.61 (GND), U11.2 (VN), U12.2, U14.1, U14.3 (GND), U15.7 (GND), U15.9 (GND), U16.7 (GND), U16.9 (GND), U17.7 (GND), U17.9 (GND), Y1.2 (G), Y1.4 (G)
GPIO12_M5A: U3.3 (IN1), U10.16 (GPIO12)
GPIO13_M5B: U3.2 (IN2), U10.17 (GPIO13)
GPIO14_M6A: U10.18 (GPIO14), U17.3 (IN1)
GPIO15_M6B: U10.19 (GPIO15), U17.2 (IN2)
GPIO16_M4A: U10.27 (GPIO16), U16.3 (IN1)
GPIO17_M4B: U10.28 (GPIO17), U16.2 (IN2)
GPIO20_M3A: U2.3 (IN1), U10.32 (GPIO20)
GPIO21_M3B: U2.2 (IN2), U10.33 (GPIO21)
GPIO22_M2A: U10.34 (GPIO22), U15.3 (IN1)
GPIO23_M2B: U10.35 (GPIO23), U15.2 (IN2)
GPIO26_M1A: U1.3 (IN1), U10.40 (GPIO26/ADC0)
GPIO27_M1B: U1.2 (IN2), U10.41 (GPIO27/ADC1)
IO1_GPIO: R55.1, U10.2 (GPIO0)
IO2_GPIO: R56.1, U10.3 (GPIO1)
IO3_GPIO: R57.1, U10.4 (GPIO2)
IO4_GPIO: R58.1, U10.5 (GPIO3)
IO5_GPIO: R59.1, U10.12 (GPIO8)
IO6_GPIO: R60.1, U10.13 (GPIO9)
LED_DIN: U10.43 (GPIO29/ADC3), U14.2
unnamed: C16.2, R28.1
unnamed: C57.1, R43.2, Y1.3
unnamed: C38.1, D2.2 (A), U8.3 (VOUT)
unnamed: C39.1, D2.1 (K), D3.1 (K), U9.3 (VIN)
unnamed: C59.1, F2.2, J4.1 (VBUS)
unnamed: J5.3 (SIG), R55.2
unnamed: J5.6 (SIG), R56.2
unnamed: J5.9 (SIG), R57.2
unnamed: J5.12 (SIG), R58.2
unnamed: J5.15 (SIG), R59.2
unnamed: J5.18 (SIG), R60.2
unnamed: J12.2, U14.4
unnamed: C71.1, C72.2, Q1.4 (G), R40.2, SW1.2 (B)
unnamed: R46.2, SW2.1
unnamed: R41.1, SW1.1 (A)
unnamed: C14.2, U4.1 (BST)
unnamed: R28.2, U4.6 (COMP)
unnamed: R26.1, R27.2, U4.5 (FB)
unnamed: R25.2, U4.4 (RT/CLK)
unnamed: C14.1, L1.1, U4.8 (SW)
unnamed: TP1.1 (1_1), U10.24 (SWCLK)
unnamed: TP2.1 (1_1), U10.25 (SWDIO)
unnamed: C51.1, R42.2, U10.46 (VREG_AVDD)
unnamed: C56.1, U10.21 (XIN), Y1.1
unnamed: R43.1, U10.22 (XOUT)
unnamed: R46.1, U10.60 (~QSPI_SS)
PACK+: C72.1, J3.2, Q1.1 (S), Q1.2 (S), Q1.3 (S), R40.1
USB_N: J1.A7 (D-), J1.B7 (D-), R45.2, U6.3 (IO2), U6.4 (IO3)
USB_P: J1.A6 (D+), J1.B6 (D+), R44.2, U6.1 (IO1), U6.6 (IO4)
VBUS: C37.1, J1.A4 (VBUS), J1.A9 (VBUS), J1.B4 (VBUS), J1.B9 (VBUS), U8.2 (VIN)
VCC: C5.1, C8.1, C12.1, C69.1, D3.2 (A), F2.1, J5.2 (5V), J5.5 (5V), J5.8 (5V), J5.11 (5V), J5.14 (5V), J5.17 (5V), J12.1, L1.2, R26.2, U11.5 (VP), U14.5 (VCC)
VSYS: C3.2, C4.1, C6.2, C7.1, C10.2, C11.1, C15.2, C71.2, C73.2, C74.2, C75.1, C76.1, C77.1, C78.1, C79.1, C80.1, D4.1 (A1), Q1.5 (D), Q1.6 (D), Q1.7 (D), Q1.8 (D), R52.1, U1.5 (VM), U2.5 (VM), U3.5 (VM), U4.2 (VIN), U4.3 (EN), U15.5 (VM), U16.5 (VM), U17.5 (VM)
