Marsgate/goosebrain/thegoose.kicad_pcb

## KiCad design thegoose.kicad_pcb (2026-08-02)

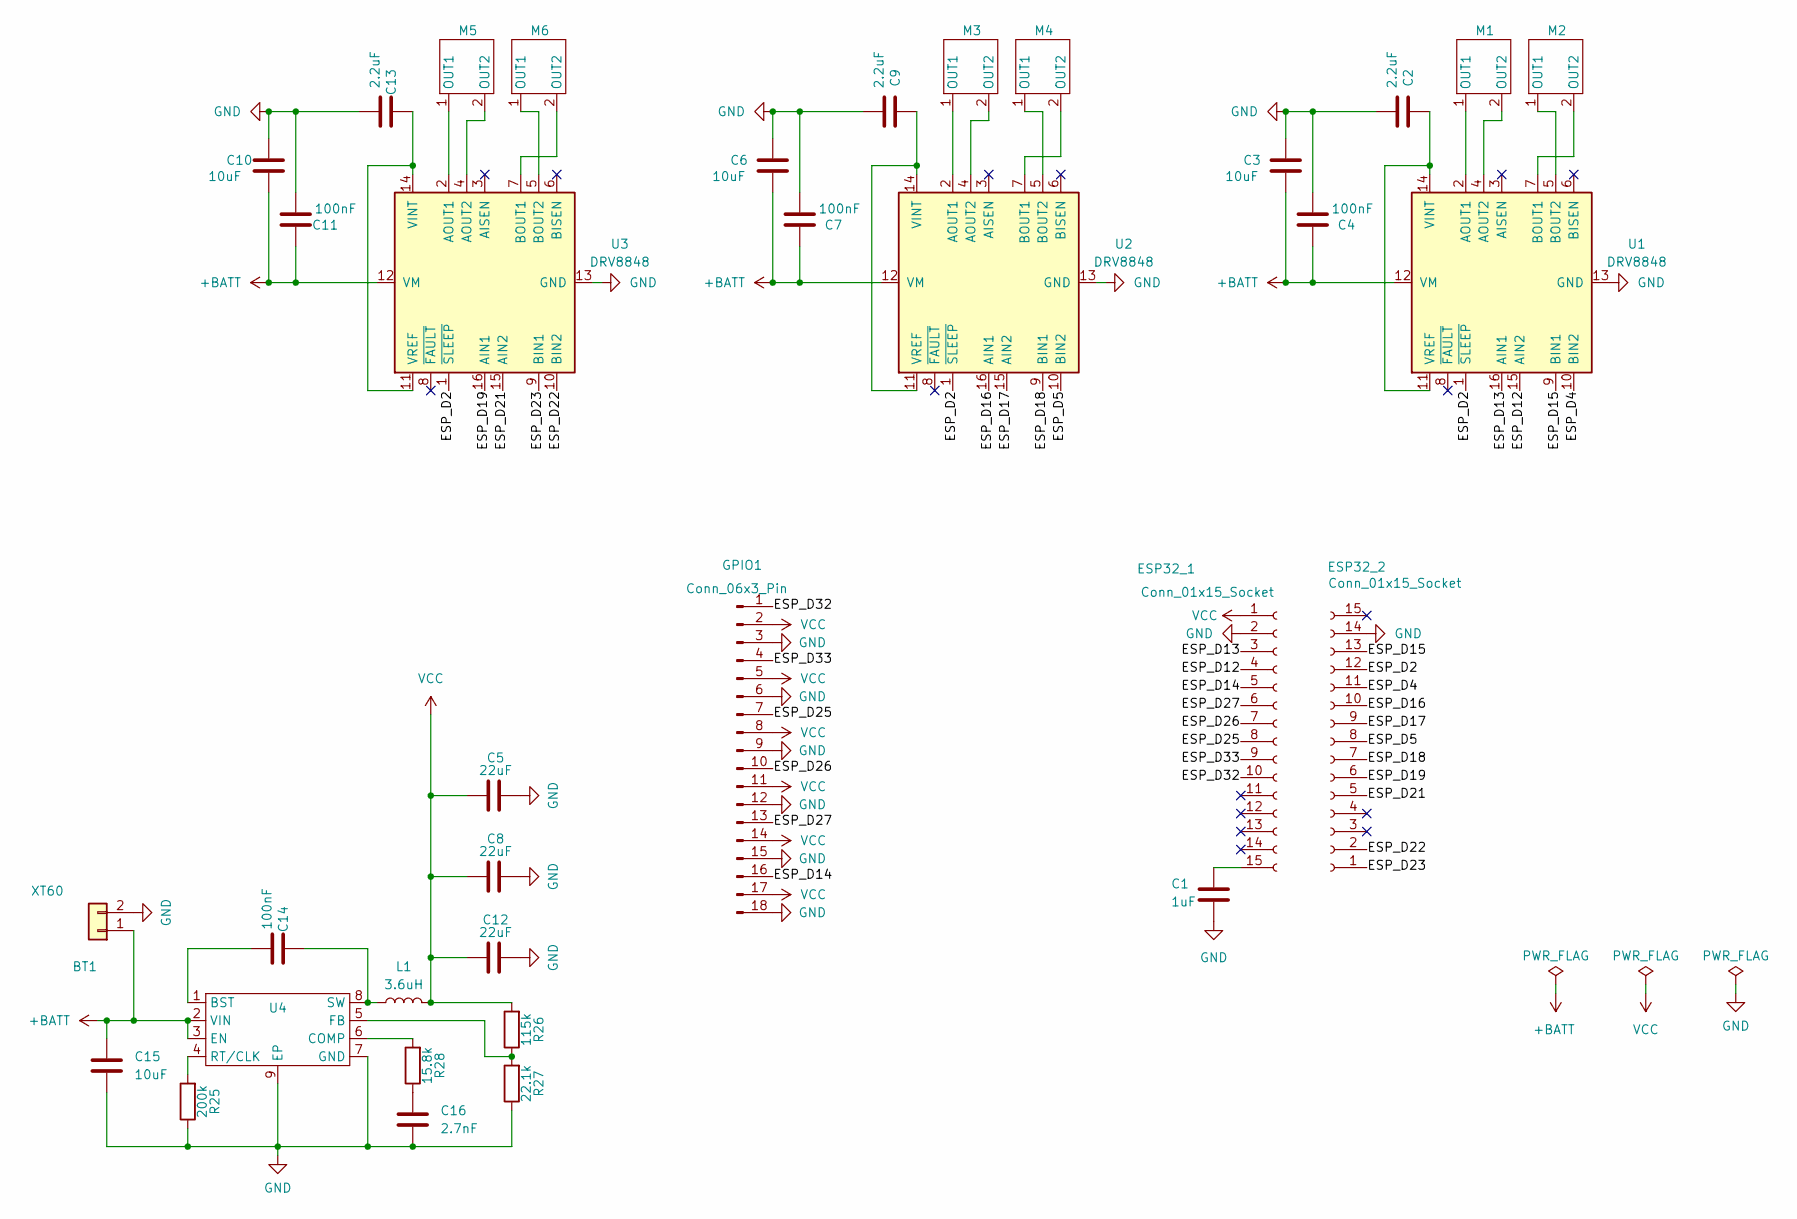
[picture p28: schematic thegoose.kicad_sch]

Parts:
BT1: XT60; AMASS_XT60PW-M_1x02_P7.20mm_Horizontal; LCSC Part # C98732
C1: 1uF; C_0805_2012Metric; LCSC Part # C28323
C2, C9, C13: 2.2uF; C_0805_2012Metric; LCSC Part # C377773
C3, C6, C10, C15: 10uF; C_0805_2012Metric; LCSC Part # C15850
C4, C7, C11, C14: 100nF; C_0805_2012Metric; LCSC Part # C49678
C5, C8, C12: 22uF; C_0603_1608Metric; LCSC Part # C59461
C16: 2.7nF; C_0603_1608Metric; LCSC Part # C302024
ESP32_1, ESP32_2: Conn_01x15_Socket; PinSocket_1x15_P2.54mm_Vertical; LCSC Part # C2932676
GPIO1: Conn_06x3_Pin; PinHeader_3x06_P2.54mm_Horizontal; LCSC Part # C42431837
L1: 3.6uH; L_Wurth_WE-LQSH-4020; LCSC Part # C7588667
M1, M2, M3, M4, M5, M6: JST_XH_S2B-XH-A_1x02_P2.50mm_Horizontal; LCSC Part # C157931
R25: 200k; R_0805_2012Metric_Pad1.20x1.40mm_HandSolder; LCSC Part # C844827
R26: 115k; R_0805_2012Metric_Pad1.20x1.40mm_HandSolder; LCSC Part # C5200544
R27: 22.1k; R_0805_2012Metric_Pad1.20x1.40mm_HandSolder; LCSC Part # C228640
R28: 15.8k; R_0805_2012Metric_Pad1.20x1.40mm_HandSolder; LCSC Part # C47115540
U1, U2, U3: DRV8848; TSSOP-16-1EP_4.4x5mm_P0.65mm; LCSC Part # C131079
U4: AP64500SP-13; Diodes_SO-8EP; LCSC Part # C2070920

Connections:
+BATT: BT1.1, C3.2, C4.1, C6.2, C7.1, C10.2, C11.1, C15.2, U1.12 (VM), U2.12 (VM), U3.12 (VM), U4.2 (VIN), U4.3 (EN)
/ESP_D2: ESP32_2.12, U1.1 (~SLEEP), U2.1 (~SLEEP), U3.1 (~SLEEP)
/ESP_D4: ESP32_2.11, U1.10 (BIN2)
/ESP_D5: ESP32_2.8, U2.10 (BIN2)
/ESP_D12: ESP32_1.4, U1.15 (AIN2)
/ESP_D13: ESP32_1.3, U1.16 (AIN1)
/ESP_D14: ESP32_1.5, GPIO1.16
/ESP_D15: ESP32_2.13, U1.9 (BIN1)
/ESP_D16: ESP32_2.10, U2.16 (AIN1)
/ESP_D17: ESP32_2.9, U2.15 (AIN2)
/ESP_D18: ESP32_2.7, U2.9 (BIN1)
/ESP_D19: ESP32_2.6, U3.16 (AIN1)
/ESP_D21: ESP32_2.5, U3.15 (AIN2)
/ESP_D22: ESP32_2.2, U3.10 (BIN2)
/ESP_D23: ESP32_2.1, U3.9 (BIN1)
/ESP_D25: ESP32_1.8, GPIO1.7
/ESP_D26: ESP32_1.7, GPIO1.10
/ESP_D27: ESP32_1.6, GPIO1.13
/ESP_D32: ESP32_1.10, GPIO1.1
/ESP_D33: ESP32_1.9, GPIO1.4
GND: BT1.2, C1.2, C2.2, C3.1, C4.2, C5.2, C6.1, C7.2, C8.2, C9.2, C10.1, C11.2, C12.2, C13.2, C15.1, C16.1, ESP32_1.2, ESP32_2.14, GPIO1.3, GPIO1.6, GPIO1.9, GPIO1.12, GPIO1.15, GPIO1.18, R25.1, R27.1, U1.13 (GND), U1.17 (GND), U2.13 (GND), U2.17 (GND), U3.13 (GND), U3.17 (GND), U4.7 (GND), U4.9 (EP)
unnamed: C16.2, R28.1
unnamed: C1.1, ESP32_1.15
unnamed: M1.1 (OUT1), U1.2 (AOUT1)
unnamed: M1.2 (OUT2), U1.4 (AOUT2)
unnamed: M2.1 (OUT1), U1.5 (BOUT2)
unnamed: M2.2 (OUT2), U1.7 (BOUT1)
unnamed: M3.1 (OUT1), U2.2 (AOUT1)
unnamed: M3.2 (OUT2), U2.4 (AOUT2)
unnamed: M4.1 (OUT1), U2.5 (BOUT2)
unnamed: M4.2 (OUT2), U2.7 (BOUT1)
unnamed: M5.1 (OUT1), U3.2 (AOUT1)
unnamed: M5.2 (OUT2), U3.4 (AOUT2)
unnamed: M6.1 (OUT1), U3.5 (BOUT2)
unnamed: M6.2 (OUT2), U3.7 (BOUT1)
unnamed: C2.1, U1.11 (VREF), U1.14 (VINT)
unnamed: C9.1, U2.11 (VREF), U2.14 (VINT)
unnamed: C13.1, U3.11 (VREF), U3.14 (VINT)
unnamed: C14.2, U4.1 (BST)
unnamed: R28.2, U4.6 (COMP)
unnamed: R26.1, R27.2, U4.5 (FB)
unnamed: R25.2, U4.4 (RT/CLK)
unnamed: C14.1, L1.1, U4.8 (SW)
VCC: C5.1, C8.1, C12.1, ESP32_1.1, GPIO1.2, GPIO1.5, GPIO1.8, GPIO1.11, GPIO1.14, GPIO1.17, L1.2, R26.2

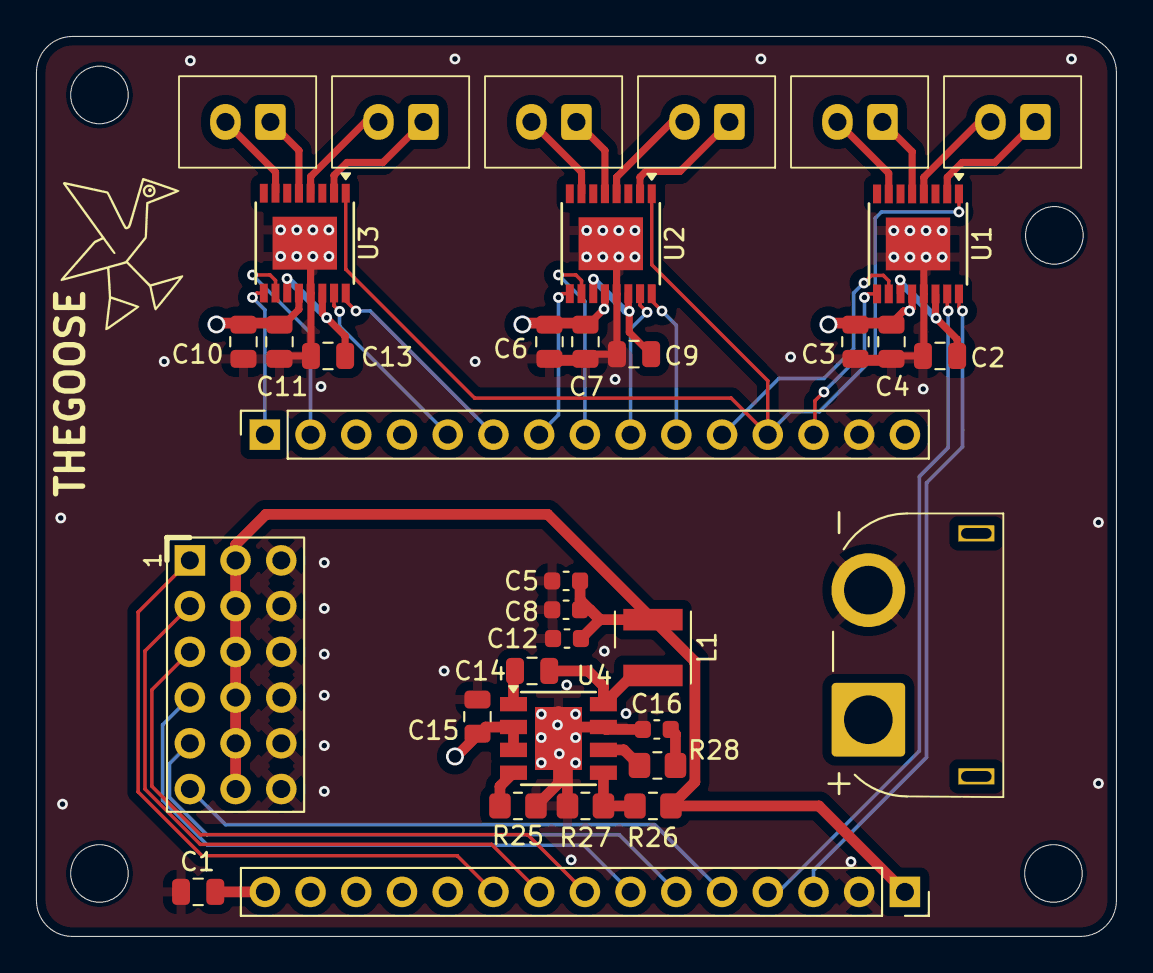
[picture p29: board thegoose.kicad_pcb from above]

Board: 4 copper layers, 60.0 x 50.0 mm, 35 parts (0 on the bottom side), 44 nets.
