Marsgate/goosebrain/(commit log)

2026-07-30 Finish initial schematic and assign footprints
2026-07-30 Start on PCB
2026-07-30 Clean up schematic layout
2026-07-30 Disconnect GPIO on schematic
2026-07-30 First iteration of PCB
2026-07-30 Fix silkscreen
2026-07-30 Add mounting holes
2026-07-31 Ignore zipped gerbers
2026-07-31 Add buck converter 3D model
2026-08-01 Remove current shunt resistors
2026-08-01 Complete PCB
2026-08-02 Update BOM
2026-08-02 Switch footprint to two 1x15 header pins for ESP32
2026-08-02 Add female pin header LCSC part numbers
2026-08-02 Add extra capacitors to buck converter
2026-08-02 Update all footprints
2026-08-02 Update footprints
2026-08-02 Update even more footprints
2026-10-15 Describe the circuit in SKiDL
    circuit/goosebrain.py describes the board as Python, one subcircuit per
    block. Its netlist matches kicad/thegoose.kicad_sch exactly (35 parts,
    44 nets). circuit/compare_netlists.py checks two KiCad netlists net by
    net, so the SKiDL source and the hand-drawn schematic can be kept in sync.
2026-10-15 Tie DRV8848 sense pins to GND
    AISEN and BISEN on U1-U3 were left open, so the H-bridges' low side had
    no return path. Without current limiting, the data sheet says to tie
    them to GND. Done in the SKiDL source, the schematic and the PCB (short
    tracks from each pad to GND).
    The PCB file is now saved in KiCad 10 format, which accounts for most of
    its diff.
2026-10-15 Add a screenshot-analyse-improve design review loop
    tools/review.py renders the schematic or PCB to zoomable images and runs
    the hard gates: ERC, netlist match against SKiDL, DRC, unrouted items,
    schematic parity and power-track widths. Read-only critic agents score
    the images against a rubric, and the schematic-loop and pcb-loop skills
    iterate edits through the KiCad MCP server until the scores and gates
    pass.
2026-10-16 Tidy the schematic with the review loop
    Six schematic-loop iterations raised the critic score from 2.9 to 4.3:
    clearer power symbols, separated wiring, block titles and design notes.
    Connectivity is unchanged (the netlist still matches SKiDL).
2026-10-16 Rev 2 circuit: RP2354A, USB host, internal 3S battery
    Replaces the ESP32 DevKit with an RP2354A. A Pico-PIO-USB host port on
    USB-A takes a 2.4 GHz controller dongle, so the board has no radio. The
    native USB goes to USB-C for UF2, upload and serial.
    USB-C also charges an internal 3S pack through a BQ25798, asking a PD
    charger for 9 V via a CH224A. The ILIM_HIZ divider keeps the charge
    current safe with no firmware. Motors and the 5 V buck run from the pack
    through a fuse and a P-FET switch, not through the charger's BATFET.
    circuit/PARTS.md lists every part with its MPN and stock. The netlist
    comparison now checks MPN as well as LCSC.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
2026-10-16 Draw the rev 2 schematic as hierarchical sheets
    Top sheet plus Power & charging, MCU & USB, Motor drivers and IO,
    redrawn from circuit/goosebrain.py and tidied with the schematic loop.
    ERC is clean and the netlist matches SKiDL, including MPN and LCSC.
    - Add footprints for the Abracon AOTA core inductor and the Amphenol
    87520 USB-A receptacle.
    - Fix L1's footprint name for KiCad 10's Wurth library.
    - Keep battery sense on VSYS so it drains nothing with the switch off.
    - Update the schematic critic's rubric for the rev 2 blocks.
2026-10-16 Lay out rev 2 with an internal pack, protector and cost-down parts
    Board is 91 x 47 mm for a 96 x 52 mm enclosure, with placement and hand
    power routing done; signal routing is still to do.
    - Internal Gens Ace 3S 1000 mAh pack on an XT60 pigtail, protected on the
    board by a BQ7791501 with back-to-back low-side FETs and a 2.5 mOhm
    shunt, plus a balance header and two NTCs.
    - USB-A and USB-C on the top edge, IO as a recessed 3 x 6 pin block, GPIO
    map re-swapped for the placement, USB nets renamed with P/N suffixes
    for the diff-pair router.
    - Cost-down swaps that keep every feature: basic or preferred passives
    and ICs, cheaper connectors, a THT power switch rated for 12.6 V, and
    re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
2026-10-16 Add a header for an external WS2812B LED stick
    J12 (JST-PH 3-pin) feeds an 8-LED WS2812B stick mounted on the case's
    top edge near the USB ports. GPIO21 drives it through a 74AHCT1G125 so
    the data line reaches the 5 V VIH, with a 330 ohm series resistor and
    10 uF at the connector. Power comes from the switched 5 V rail; firmware
    should cap brightness (about 0.5 A at full white).
2026-10-17 Re-lay out rev 2 around an Ovonic 450 pack on top of the board
    The internal pack is now an Ovonic 3S 450 mAh XT30 pack sitting 2 mm
    above the board over the low-power logic area, on an XT30 pigtail. The
    board is 88.5 x 47 mm with 2 mm corner radii, for a box of about
    93.5 x 52 x 24.6 mm whose face has no openings.
    - IO S1-S6 are a 3 x 6 right-angle header out of the left end, beside
    M5/M6, replacing the recessed vertical block.
    - BOOT is a side-push switch on the top edge behind a pinhole sized for
    a 2.5 mm hex key; RESET is removed, with RUN on a bottom test pad
    beside SWCLK/SWDIO/GND.
    - The CHG LED is a side-view part on the top edge; the GPIO status LED
    is removed now that the WS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
2026-10-17 Fit the standard Ovonic 450 pack and recess the IO header
    The earlier 50.5 x 25 x 14 mm pack size came from a mislabeled listing.
    The layout now uses the standard Ovonic 80C 3S 450 mAh pack (design
    envelope 46.5 x 25 x 21 mm) on top of the board, for a box of about
    93.5 x 52 x 30 mm; the Long Size pack would have needed a ~110 mm box.
    - S1-S6 (J5) move 5.55 mm inboard so the pin tips end 1 mm inside the
    left wall; the FET/shunt strip and nearby passives shift to suit.
    - The pack carries a female XT30U-F, so J3 takes a male XT30U-M pigtail
    on 16 AWG. A vertical XT30UPB-M was checked and misses the 1 mm
    clearance under the face.
    - IO1-IO4 GPIOs reordered for the new placement.
    Schemati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
2026-10-17 Use a vertical XT30 on the board instead of the pack pigtail
    J3 is now an Amass XT30UPB-M (male, vertical, C428721) that the pack's
    female XT30U-F plugs straight into; the pigtail pads and the reserved
    mated-pair strip are removed and the pack power path re-routed.
    The mated connector plus the 16 AWG bend needs 22.1-24.1 mm above the
    board against 23.4 mm under the face of the 30 mm box. That is logged as
    an enclosure open item to settle on the first prototype.
    Schematic review passes; PCB review passes every gate except unrouted.
2026-10-18 Route rev 2 on a 6-layer board
    Four layers couldn't route the fan-out around the RP2354A, so the board
    moves to JLC's standard 1.6 mm 6-layer stack (JLC06161H-3313, ENIG,
    via-in-pad): F signals, In1 GND, In2 signals, In3 power planes, In4 GND,
    B signals. Placement is unchanged.
    Review 53 passes every gate: nothing unrouted, 0 DRC errors. The critic
    stopped at 3.9 after 10 iterations; the open findings are in
    build/review/pcb/LOG.md, including DVDD pin 23's 100 nF (C54) sitting
    about 11 mm of copper away.
    Also adds the inner3/inner4 review views, the 6-layer quotes in
    PARTS.md, and fixes the core-regulator note's cap names.
2026-10-18 Move C54 next to DVDD pin 23
    C54 (pin 23's 100 nF) sat at U10's bottom-left corner, 11 mm of copper
    from the pin through two vias and an In2 jumper. It now sits directly
    left of pin 23 in R43's old spot: about 1.3 mm of F.Cu, with a GND via
    in its pad.
    To make room, R43 turns vertical under Y1, and XOUT runs down between
    Y1 and C54. SWDIO passes under C54 to a new via and goes straight west
    on B.Cu to TP2, which drops the In2 detour. Y1 pad 4's GND via moves
    into the pad, and the IO1 via shifts 0.5 mm left.
    Review 54: all gates pass, no new DRC types.
2026-10-18 Add a fab script and rewrite the README for rev 2
    tools/fab.py builds build/fab/ from the board:
    - Gerbers for all six copper layers, plus PTH and NPTH drill files, zipped
    for JLC;
    - JLC's assembly BOM and placement files, machine-placed SMD only;
    - a full BOM with MPN, manufacturer, LCSC number and an Assembly column
    (JLC SMT, Hand-place, Hand-solder).
    The README now covers the rev 2 hardware, charging behaviour, programming
    (UF2 via the BOOT pinhole, Arduino), the GPIO map, the IO and LED-stick
    pinouts, and how to order and finish the boards.
2026-10-18 Double the M2/M4 output vias and record the pre-order checks
    M2 and M4's OUT1 each changed layers through a single 0.3 mm via. Each
    now has a second via beside the first, tied on both layers. OUT2's B.Cu
    run leaves from its own second via to make room, and M2 OUT1's B.Cu run
    is widened to 0.6 mm. Every motor output that changes layers now does it
    through two vias.
    PARTS.md records two datasheet checks:
    - CH224A: CFG1 = 6.8 kOhm requests 9 V (WCH datasheet Table 5-1), and the
    VHV/VBUS hookup matches the reference schematic.
    - SRV05-4: the R+O pinout matches the symbol (I/O on 1, 3, 4 and 6, VP on
    5, GND on 2).
    Review 55: all gates pass, no new DRC types.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
2026-10-19 Start from goosebrain rev 2 with the routing removed
    Copied from Marsgate/goosebrain, branch rev2-rp2350 at 0ed7122 plus its
    uncommitted working tree on 2026-10-19: the schematic, placement, net
    classes, DRC rules, libraries and fab script. The AI's tracks, vias,
    local pours and In3 plane splits are gone; the board-wide GND pours stay,
    unfilled. The README covers the routing rules and ordering.
2026-10-19 Fix the buck inductor, soft-start VSYS and limit motor current
    Circuit (goosebrain.py, PARTS.md, schematic):
    - L1 is a Coilcraft XAL5030-222 (Isat 9.2 A, the AP64500's max current
    limit). The old CR4030 saturated at about 3.1 A.
    - VSYS soft start and clamp: C71 gate-drain and C72 gate-source on Q1,
    R40 27k, R41 10k, and an SMF14A TVS (D4) on VSYS.
    - Each DRV8848 chops at about 1.33 A per bridge: 0.15 R sense resistors
    on AISEN/BISEN and a 15k/10k VREF divider from VINT, so six stalled
    motors can't reach the protector's OCD1 trip.
    - U4 gets a second 10 uF (C73) and a 100 nF (C74) at VIN.
    - Stock swaps after a full JLC stock check: D4 to the Littelfuse SMF14A,
    the sense resistors to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
2026-10-19 Add VIN bulk caps C73/C74 and note the buck output cap height
    Pulled from goosebrain 114357a: C73 (10uF 0805) and C74 (100nF 0402) on
    the power sheet, and the PARTS.md note that C5/C8/C12 stay at 1206 under
    the pack.
2026-10-19 Split into brain + smart pack, and support 2S packs
    Brain/pack split: charging, protection and the fuse move off the brain
    into a separate smart pack board (kicad-pack/goosepack), with its own
    USB-C charging port. The brain drops to 4 layers, loses the charger,
    PD sink, protector and SY6280, and swaps the DRV8848s for DRV8871s.
    2S support on the brain:
    - DRV8871 -> DRV8251A (same HSOP-8 footprint, 4.5-48 V VM). Shared VREF
    divider R107/R108/C81 from +3V3 (2.53 V) and 1.18k IPROPI resistors
    keep the 1.36 A limit.
    - Q1 gate divider 27k/10k -> 47k/4.7k for -5.1 V drive at an empty 2S
    pack; C71 4.7n -> 10n to keep the ~70 us soft start.
    New 2S pack variant (kicad-pack-2s/goosepack2s): BQ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
2026-10-19 Fill in LCSC numbers, swap to stocked parts, tidy the new schematic parts
    - LCSC numbers from JLC's 2026-10-19 in-stock catalog for every new part
    except the DRV8251A, which JLC doesn't stock (Global Sourcing or consign).
    - 2S protector S-8252AAH -> HY2120-LB (C168778): pin-for-pin the same,
    OV 4.25 V / UV 2.80 V, stocked at JLC. R94 trip recovery still holds.
    - IPROPI R101-R106 1.18k (2,341 in stock) -> 1.2k preferred (C25862),
    so the motor limit is 1.34 A.
    - Fix the 2S pack board's footprint-symbol links (paths were dropped in
    the previous commit); both boards now link every footprint correctly.
    - Move the VREF divider and the balancer block into clear space and
    rewrite the stale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
2026-10-19 Swap J3 to a horizontal XT30 and compact the brain to 78 x 46.5 mm
    - J3: XT30PW-M30.G.Y (C431092) on Connector_AMASS:AMASS_XT30PW-M
    horizontal, bottom edge, mouth out through the wall. Pin 1 PACK-/GND,
    pin 2 PACK+. Hole pattern checked against the Amass drawing.
    - Placement compacted from 88.5 x 47 mm to 78 x 46.5 mm (-532.5 mm2,
    -12.8 %; 10.5 mm shorter). Blocks moved as units; edge connectors stay
    on their walls; buck loop and driver-beside-connector kept.
    - R107/R108/C81 placed; Edge.Cuts redrawn with 2 mm corners; mounting
    holes, fiducials, GND pours and USB rule areas moved to match.
    - Stale pack-envelope and vertical-XT30 fab notes removed or rewritten.
    - README/PARTS: new si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
2026-10-19 Compact the brain further to 73.4 x 43 mm (option B), no mounting holes
    - Driver caps and IPROPI resistors moved into a row under each driver,
    next to its VM pin; the motor column moves 4.6 mm left.
    - MCU and buck blocks stacked directly under J4; the USB-A strip
    (U11, R48, R49, F2, C59) and the 3.3 V rail (U9, C39, D2, D3) share
    the bottom-right corner. USB-A fan-out rule area moved with U11.
    - D4, C15, the VREF divider and FID2 in the column beside J3.
    - M3 mounting holes removed; the case holds the board, with a rib
    behind J3 for the plug force.
    - 1,003 mm2 (24 %) smaller than the original 88.5 x 47 mm.
    DRC: no clearance or courtyard errors, no parts outside the outline,
    schemati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
2026-10-19 Correct the 2S pack cutoff to 2.8 V per cell (5.6 V)
    The HY2120-LB cuts off at 2.80 V per cell and releases at 3.00 V; the
    README had the release voltage as the cutoff.
2026-10-19 Give the six DRV8251As LCSC C5218844 so JLC places them
    The genuine TI DRV8251ADDAR is stocked at LCSC as C5218844, so the motor
    drivers no longer need Global Sourcing or consigning. fab.py now puts
    U1-U3 and U15-U17 in the JLC BOM and CPL with nothing flagged.
2026-10-20 Baseline before double-sided build
    The working tree as handed over: schematics, board, hexy.pretty
    footprints and the new STEP models in kicad/3dmodels (now tracked
    through a .gitignore exception), plus the double-sided handoff.
2026-10-20 Place the brain double-sided at 66.3 x 34 mm, unrouted
    - tools/place_double.py rebuilds the placement from scratch: parts on both
    sides, M1-M6 swapped to JST PH S2B-PH-K (C173752), J3 under J4, the
    switches in the bottom-right corner, the USB-C ESD and series resistors
    on the front between J1 and U10.
    - Pulls in the 2026-10-20 schematic change (IO5/IO6 off the ADC pins,
    R109/R114 15k USB-A pull-downs).
    - Reassigns U10 GPIOs for the new layout, keeping each motor on its own
    PWM slice and IO4-IO6 on slices 1 and 4; USB-A moves to GPIO26/27.
    - Adds back-side fiducials FID4-FID6.
    - The old partial autoroute is kept in kicad/reference/.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
2026-10-20 Rotate U10 to 0 deg and re-place the brain at 66.6 x 32 mm, unrouted
    USB now runs straight down from J1 into U10's north pins; IO goes west to J5,
    which moves to the top of the left wall with M5/M6 below it. SW1 sits under
    U16 and SW2 in the bottom-right corner; Q1 is east of J3. GPIO map redone for
    the new orientation (IO1-6 on GPIO0-3/8/9, motors on GPIO12-17/20-23/26-27,
    USB-A on GPIO24/25, LED on GPIO29). ERC clean, DRC parity clean.
2026-10-20 4-layer attempt: 68.2 x 32 mm placement and scripted critical routing
    U6 moves to the back so the USB-C pair runs via-free from J1's A6/B7 to U10.
    J4 shifts 0.4 mm west and the board widens 1.6 mm to open a riser channel
    to the right drivers. tools/route_recipe.py now scripts the U10 fan-out,
    USB-C/USB-A, crystal, core regulator, buck loop, driver power, battery
    entry, VCC feeds and planes. fab.py writes bottom-side CPL rows.
    Freerouting still leaves 27-60 connections open (see ROUTING_LOG.md).
2026-10-20 Route the brain on 6 layers: 68.2 x 32 mm, 0 DRC errors, 0 unconnected
    JLC06161H-3313 stackup (In1/In4 solid GND, In2 signals, In3 power areas),
    USB at 0.124/0.127 mm for 90 ohm. route_recipe.py scripts the critical nets
    and U10's west and south-west escapes; grid_router.py (a small A* router)
    replaces Freerouting for the rest; prune.py, plane_channels.py and stitch.py
    tidy vias, lay In3 GND under In2 signals and stitch the GND pours.
2026-10-20 Place the brain's silkscreen and clip In3 channels to the power areas
    tools/silk.py trims footprint silk to the outline, puts 101 of 125 references
    beside their parts on their own side (clear of pads, silk and the edge), and
    moves the goose logo onto the back at 80 %. plane_channels.py now only lays
    In3 GND where an In2 signal crosses a power area. DRC: 0 errors, 0
    unconnected; the only warnings are 8 footprints that differ from their
    library copies (trimmed silk).
2026-10-20 Cut In3 channels into the power areas, move IO1 to B.Cu, add route_all.py
    plane_channels.py now cuts GND channels out of the In3 power areas under
    every In2 signal (a zone keeps one outline, so the old single channel zone
    was mostly lost). IO1 runs on B.Cu so its channel doesn't sever the VCC band
    from the VCC block. route_all.py rebuilds all copper from the placement:
    0 DRC errors, 0 unconnected, 0 parity issues. ROUTING_LOG.md covers the
    6-layer decision, the router passes, trade-offs and shortfalls.
2026-10-20 Document the double-sided 6-layer brain in README and PARTS
    Stackup JLC06161H-3313 and USB 90 ohm numbers, 68.2 x 32 mm placement and
    wall openings, box = outline + 5 mm with a 2 mm gap under the board,
    Standard PCBA on both sides with edge rails and POFV, the GPIO map that
    matches the schematic, routing status, and the JST PH motor connectors.
2026-10-20 Retire the SKiDL generator after the goosebrain-manual merge
    The KiCad schematics are now the source of truth: circuit/goosebrain.py,
    circuit/compare_netlists.py and circuit/PARTS.md described the old
    charger/DRV8848 design and were removed.
    - tools/review.py: drop the SKiDL netlist gate (the sch review still saves
    schematic.net for diffing) and set the power-width check to today's
    nets: PACK+/VSYS 1.0 mm, VCC and the USB-A VBUS 0.5 mm, GND and the
    motor outputs 0.4 mm. Both reviews pass on the current board.
    - requirements.txt: drop skidl (PyMuPDF and Pillow are still used).
    - .claude agents and the schematic-loop skill: describe the double-sided
    board and point at the schematic, R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
2026-10-20 Make every port flush with the case wall
    Move J1 (USB-C) out 0.27 mm (its shell pads now sit at the 0.3 mm edge
    limit), J4 (USB-A) out 1.76 mm and J3 (XT30) out 1.83 mm, so their faces
    overhang the edge by 1.4 mm like the side connectors' 1.9 mm. SW1 moves
    out 0.5 mm so its lever clears the wall by about 1.7 mm. J4's ESD,
    pull-downs, PTC and VBUS cap and the parts between J3's pins move with
    them; C46 and C69 move clear of D2 and J4's shell peg.
    Routing rebuilt with route_all.py: 0 DRC errors, 0 unconnected, 0 parity
    issues. Recipe fixes: U11's VCC hop via follows U11, the In3 VCC area
    reaches C69, and the In3 VSYS bottom strip passes north of J3's pegs.
    prune.py now joins track ends to a r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
2026-10-20 Add tools/unroute.py and ignore its snapshot and tscircuit leftovers
    unroute.py copies the brain into a separate unrouted KiCad project for
    routing by hand. Its output (kicad/thegoose-manual.*) is a throwaway
    snapshot, and tscircuit/ is build output left behind by the
    tscircuit-prototype branch, so both are ignored.
2026-10-20 Update PCBA component placement
2026-10-20 Replace the RP2354 core inductor with a 1.1 V LDO and fix JLC placements
    L3 (the Abracon AOTA-B201610S3R3-101-T, the only polarity-marked inductor
    RPi approves) had 3 in stock at JLC. DVDD now comes from U12, a TLV74311
    LDO on +3V3 with C87/C86, as in RP2350 datasheet Fig. 24: VREG_FB to GND,
    VREG_LX open, VREG_VIN and VREG_AVDD still powered. Firmware must set the
    VREG HIZ bit after boot and never use the regulator's low-power mode.
    - Schematic, placement, recipe, grid router and DRU updated; the copper
    is rebuilt with route_all. DRC, ERC and parity are clean.
    - fab.py: JLC rotation offsets for the JST PH connectors, J3's XT30 and
    SW1 (all 180 degrees), and U8 placed at its pad centre,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
2026-10-20 Centre J3 and J4 on their pad centres in the JLC CPL
    JLC's footprints for the XT30PW-M (C431092) and the USB-A (C456018) are
    centred midway between their pad centres. fab.py used the centre of the
    pad copper, which is 0.525 mm off for both because their pin and peg or
    shell pads differ in size, so J3's pins sat off-centre in their holes in
    JLC's placement preview.
2026-10-20 Have JLC place SW2, D4, U14 and F2, and shift U8 onto its model
    - SW2 (BOOT), D4, U14 and F2 were DNP for hand placement. All four are
    in stock at JLC, so they're placed now (DNP cleared in the schematic
    and on the board). The JLC BOM grows from 47 to 51 lines.
    - fab.py: JLC's SOT-89-3 model for U8 (C16106) sits 0.474 mm toward the
    tab from its footprint origin, so U8's CPL point moves that far toward
    its pins (JLC_PART_SHIFT), replacing the pad-centre approximation.
    - The 10-panel JLC quote is $331.69, and the preview shows all five parts
    correct.
2026-10-27 Rework the pack charger layout and route the pack board with grid_router
    The 3S pack board (kicad-pack/goosepack, 50 x 23 mm, 4 layers) is placed,
    routed and finished by scripts alone: tools/place_pack.py compact, then
    tools/route_pack.py setup / route / finish, then tools/silk.py pack.
    Placement and setup:
    - Charger power stage after TI's BQ25798 layout example: U7's power pins
    face L2, SYS and PMID cap rows on F.Cu pours at the pins with the 100 nF
    caps nearest, PGND out between L2's pads to vias under its body.
    - Kelvin sense from R66's pad edges to R68/R69 on B.Cu, kept off the fills
    by rule areas.
    - Both boot loops laid in setup: C18 under L2 on the SW1 pour, BTST1 by
    B.Cu; C19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
2026-10-28 Have JLC place every 3S pack SMD part and document the pack process
    - Clear DNP on L2, Q2, Q3, R66, TH1 and F1 (schematic and board); PARTS.md
    and README updated.
    - Route with 0.3 mm via drills, extend ROUTE_ORDER, stage finish; lead-free
    HASL in the stackup.
    - Add docs/3s-pack-process.md, the placement-to-JLC-order recipe, linked
    from the README, and the brain/pack side-by-side render.
2026-10-29 Place and route the 2S pack board and add a --board switch to the pack tools
    Every pack tool takes --board=pack2s (tools/packcfg.py); the 3S defaults and
    placement are unchanged. The 2S board is 45 x 23 mm, routed with grid_router,
    DRC-clean with schematic parity. The schematic is synced to the 3S fixes (J2/J3
    pigtail pads, 0402 boot caps, SMBJ15A, RALEC R34), JLC places F1, L2, Q2 and Q3,
    and TH2 became a fixed 10k R79 as on 3S. docs/2s-pack-process.md lists the
    differences from the 3S process.
2026-10-29 Stop asking JLC for edge rails on the Economic PCBA pack orders
    JLC does edge rails as V-cut, which Economic PCBA doesn't support, so the remark
    held order Y16. Pack boards go as single PCBs with no remark.
